vyges/sg13cmos5l_vyges_ip__ldo_capless/gds/README.md

# Layout

| File | Top cell | Size (µm) | What it is |
| --- | --- | --- | --- |
| `sg13cmos5l_vyges_ip__ldo_capless.gds` | `sg13cmos5l_vyges_ip__ldo_capless` | 527.15 × 269.00 | The LDO as a reusable block: its own prBoundary, pins named by its ports (`vin`, `vout`, `vddd`, `vss`, `vref_bg`, `ibias`, `en`, `ilim_en`, `vtrim0`–`vtrim4`, `pgood`, `oc`) |
| `slot_11.gds` | `slot_11` | 537.15 × 273.00 | The Chipalooza slot 11 hand-off: one instance of the block at (4, 2), the wrapper pins it uses, and a straight stub from each to the block pin facing it |

This is the `layout-refine` layout (2026-10-26): TopMetal1 supply grid, guard rings on every region, one digital row,
`vdd_1v2` routed 1 µm wide, `vfb` under a spacing rule, pgood above the feedback ladder. The taped-out layout
(2026-10-19) is the one on `main`.

Rebuilt 2026-11-09 for the PDK's FULL KLayout rule set: the main tables and the maximal deck, as IHP's
`run_drc.py` runs them. The earlier build passed the main tables but had 141 maximal-deck errors (LU.a 58,
NW.e1 9, M2.d 73, M3.d 1). The fixes are full-height n-ties in the pass array, the HV tap enclosure and a
min-area step.

Checks on both files (2026-11-09; IHP-Open-PDK KLayout decks, block alone and in the slot):

- DRC 0 on the full rule set (`run_drc.py`, main + maximal, no density), antenna 0, and every unused
  wrapper pin clear of our metal.
- LVS: every device and net matches except the 11 folded `rhigh` resistors. The deck extracts a serpentine
  as segment length plus bends, so it can never equal a straight schematic `l` (IHP-Open-PDK#746). Each
  is signed off by VALUE instead: its segment is drawn so that the PDK's own resistance for the folded
  device (the PyCell's `rhigh r=` value) equals the straight schematic resistor's within 0.007 %. LVS
  confirms the layout's bends and widths are the ones recorded, and LVS with the folded parameters
  substituted matches.

Generated by chipalooza `tools/slot_route_run.sh 11` from the xschem schematic in `xschem/`.
