vyges/sg13cmos5l_vyges_ip__ldo_capless/doc/figures/README.md

# LDO presentation figures

Last updated: 2026-10-18

Slide figures for `ldo_capless`, drawn with cirfig_gen (one SVG per figure, sized in pt; insert at
100 % and never resize). Each figure has its SVG, the editable JSON layout, and a PNG preview.

**These figures are drawn from descriptions. The xschem schematics in `xschem/` (generated,
ERC/LVS-checked) are the source of truth.** The xschem exports in `doc/schematics/` are unchanged.

| Figure | Size (pt) | What it shows |
|---|---|---|
| `ldo_top.svg` | 824.00 x 367.64 | Regulation loop: error amplifier `x_amp`, pass device `Mpass`, `Cc` (eout to vout), `Cout`, preload `Mpre`, feedback divider `Rtop` + `R_trim`, and the current-limit path (`Msense`, `Mcas`, `Mref`, `Mocp/Mocn`, `Mlim`). |
| `ldo_erramp.svg` | 801.43 x 322.88 | `ldo_erramp` transistor level: PMOS-input pair `M1`/`M2`, mirror load `M3`/`M4`, second stage `M5`/`M6`, Miller `Rz`-`Cm`, bias `Mr`/`Mn1`/`Mp0`/`Mtail`, enable pull-down `Men1`. |
| `ldo_ilim.svg` | 788.32 x 352.65 | `ldo_ilim`: sense `Msense` + cascode `Mcas` against `Mref` (node oc_n is the comparison), throttle `Mocp/Mocn` -> `Mlim`, OC flag `Moc`/`Roc`/`Xinv_oc`, enable `Xinv_ie`/`Mdis_oc`, sense-node sink `Msd`. |
| `ldo_trim.svg` | 829.33 x 223.19 | `ldo_fbtrim`: `Rtop`, `Rbase`, and the five binary-weighted segments `Rt0`-`Rt4` (drawn lengths 6.8/13.6/27.3/54.6/109.1 um, 1:2:4:8:16), each shorted by `Msw0`-`Msw4` on `vtrim0`-`vtrim4`. |

## Drawing conventions

- The VDD symbol is `vin` (3.3 V); the GND symbol is `vss`. `vddd` (1.2 V) appears as the terminal `VDDD` in `ldo_ilim.svg`.
- Bulk terminals are not drawn. In the schematics every PMOS bulk is `vin` and every NMOS bulk is `vss`
  (this includes `Mcas`, whose source is `sense_d` but whose bulk is `vin`).
- Terminal labels name schematic nets: VREF=vref, VFB=vfb, VEOUT=eout, VOUT=vout, IBIAS=ibias (the gate
  line of the harness bias mirror), ENn=en_n, ILIMEN=ilim_en, VDDD=vddd, OC=oc, VTRIMk=vtrimk.
  A terminal label used twice in one figure is the same net.
- Amplifier polarity in `ldo_top.svg`, derived from `ldo_erramp.sch`: `vfb` is the non-inverting input
  (vfb up -> eout1 down -> eout up) and `vref` the inverting one; the pass PMOS inverts again, so the loop is negative.
- Device multipliers are written out where they matter: `Mpass` is one device with m=64.

## Simplifications (top level only)

- `x_amp` is drawn as an amplifier symbol (its transistors are in `ldo_erramp.svg`).
- The trim ladder below `vfb` (`Rbase`, `Rt0`-`Rt4`, `Msw0`-`Msw4`) is drawn as one resistor `R_trim`; `vtrim[4:0]` is not drawn. See `ldo_trim.svg`.
- In the current limiter, `Mocp`+`Mocn` are drawn as one inverter (they are a CMOS inverter between vin and vss);
  `Msd`, `Mdis_oc`, `Xinv_ie` and the OC flag path (`Roc`, `Moc`, `Xinv_oc`) are left out. All are in `ldo_ilim.svg`.
- Not drawn: `x_vref` (shown as the VREF terminal), `x_boost`, `x_en`, `x_pg`; and the `ibias`/`en_n` pins of `x_amp`.

## Verification

Each table below was generated by extracting connectivity from the `.sch` geometry (instance pin
positions from the PDK/local symbols, nets from the xschem wire labels) and comparing it, pin by pin,
with the connectivity of the figure's own wires (union of wires, junctions and pins). The extractor
reproduces `sim/netlist/*.spice` exactly for every LDO cell. A figure passes only when every drawn
pin lands on the schematic net, no figure net joins two schematic nets, no schematic net is split
(except supplies, which have one symbol per pin by rule), and every schematic device is either drawn or
listed as not drawn. The checker was confirmed to fail on a swapped mapping before use.

Render check (`tools/render.py`): every figure reports "all wire ends on pins or wires". No wire
crossings in any LDO figure.

#### Check: ldo_top.svg vs xschem/ldo_capless.sch (flattened one level)

Devices: schematic 82 instances (flattened one level, including the hierarchy wrappers), drawn 12 symbols, two of which stand for device groups (R_trim = x_fb ladder; the inverter = Mocp+Mocn); not drawn: x_amp/ (transistors drawn in ldo_erramp.svg; shown as the amplifier symbol); x_pass (hierarchy wrapper of Mpass); x_fb (hierarchy wrapper); x_fb/Rbase (with Rt0-Rt4, Msw0-Msw4 drawn as one resistor R_trim; see ldo_trim.svg); x_il (hierarchy wrapper); x_il/Mocp (with Mocn drawn as one inverter); x_il/Mocn (drawn as the inverter); x_il/Msd (weak sense-node sink); x_il/Mdis_oc (ILIM_EN disable); x_il/Xinv_ie (ILIM_EN inverter); x_il/Roc (OC flag level shift); x_il/Moc (OC flag level shift); x_il/Xinv_oc (OC flag output; all in ldo_ilim.svg); x_vref (reference divider, shown as the V_REF terminal); x_vref/ (reference divider); x_boost (load-release slew boost); x_boost/ (slew boost); x_en (enable); x_en/ (enable); x_pg (power-good comparator); x_pg/ (power-good); x_fb/Rt0 (in R_trim); x_fb/Msw0 (in R_trim); x_fb/Rt1 (in R_trim); x_fb/Msw1 (in R_trim); x_fb/Rt2 (in R_trim); x_fb/Msw2 (in R_trim); x_fb/Rt3 (in R_trim); x_fb/Msw3 (in R_trim); x_fb/Rt4 (in R_trim); x_fb/Msw4 (in R_trim).

| Figure symbol | Schematic device | Pin | Schematic net | Figure net | Match |
|---|---|---|---|---|---|
| x_amp | x_amp | vfb | vfb | internal node | yes |
| x_amp | x_amp | vref | vref | VREF (terminal) | yes |
| x_amp | x_amp | eout | eout | internal node | yes |
| Mpass | x_pass/Mpass | G | eout | internal node | yes |
| Mpass | x_pass/Mpass | D | vout | VOUT (terminal) | yes |
| Mpass | x_pass/Mpass | S | vin | VDD symbol | yes |
| Mpre | Mpre | G | ibias | IBIAS (terminal) | yes |
| Mpre | Mpre | D | vout | VOUT (terminal) | yes |
| Mpre | Mpre | S | vss | GND symbol | yes |
| Cc | Cc | c0 | eout | internal node | yes |
| Cc | Cc | c1 | vout | VOUT (terminal) | yes |
| Cout | Cout | c0 | vout | VOUT (terminal) | yes |
| Cout | Cout | c1 | vss | GND symbol | yes |
| Rtop | x_fb/Rtop | P | vout | VOUT (terminal) | yes |
| Rtop | x_fb/Rtop | M | vfb | internal node | yes |
| Rtrim | x_fb ladder | top | vfb | internal node | yes |
| Rtrim | x_fb ladder | bot | vss | GND symbol | yes |
| Msense | x_il/Msense | G | eout | internal node | yes |
| Msense | x_il/Msense | D | x_il/sense_d | internal node | yes |
| Msense | x_il/Msense | S | vin | VDD symbol | yes |
| Mcas | x_il/Mcas | G | vout | VOUT (terminal) | yes |
| Mcas | x_il/Mcas | D | x_il/oc_n | internal node | yes |
| Mcas | x_il/Mcas | S | x_il/sense_d | internal node | yes |
| Mref | x_il/Mref | G | ibias | IBIAS (terminal) | yes |
| Mref | x_il/Mref | D | x_il/oc_n | internal node | yes |
| Mref | x_il/Mref | S | vss | GND symbol | yes |
| Xocinv | x_il/Mocp+Mocn | A | x_il/oc_n | internal node | yes |
| Xocinv | x_il/Mocp+Mocn | Y | x_il/oc_nb | internal node | yes |
| Mlim | x_il/Mlim | G | x_il/oc_nb | internal node | yes |
| Mlim | x_il/Mlim | D | eout | internal node | yes |
| Mlim | x_il/Mlim | S | vin | VDD symbol | yes |

Net check: PASS

#### Check: ldo_erramp.svg vs xschem/ldo_erramp.sch

Devices: schematic 13, drawn 13.

| Figure symbol | Schematic device | Pin | Schematic net | Figure net | Match |
|---|---|---|---|---|---|
| Mp0 | Mp0 | G | pbias | internal node | yes |
| Mp0 | Mp0 | D | pbias | internal node | yes |
| Mp0 | Mp0 | S | vin | VDD symbol | yes |
| Mtail | Mtail | G | pbias | internal node | yes |
| Mtail | Mtail | D | ptail | internal node | yes |
| Mtail | Mtail | S | vin | VDD symbol | yes |
| M1 | M1 | G | vref | VREF (terminal) | yes |
| M1 | M1 | D | n3 | internal node | yes |
| M1 | M1 | S | ptail | internal node | yes |
| M2 | M2 | G | vfb | VFB (terminal) | yes |
| M2 | M2 | D | eout1 | internal node | yes |
| M2 | M2 | S | ptail | internal node | yes |
| M3 | M3 | G | n3 | internal node | yes |
| M3 | M3 | D | n3 | internal node | yes |
| M3 | M3 | S | vss | GND symbol | yes |
| M4 | M4 | G | n3 | internal node | yes |
| M4 | M4 | D | eout1 | internal node | yes |
| M4 | M4 | S | vss | GND symbol | yes |
| M5 | M5 | G | eout1 | internal node | yes |
| M5 | M5 | D | eout | VEOUT (terminal) | yes |
| M5 | M5 | S | vss | GND symbol | yes |
| M6 | M6 | G | pbias | internal node | yes |
| M6 | M6 | D | eout | VEOUT (terminal) | yes |
| M6 | M6 | S | vin | VDD symbol | yes |
| Men1 | Men1 | G | en_n | ENn (terminal) | yes |
| Men1 | Men1 | D | eout1 | internal node | yes |
| Men1 | Men1 | S | vss | GND symbol | yes |
| Mn1 | Mn1 | G | ibias | IBIAS (terminal) | yes |
| Mn1 | Mn1 | D | pbias | internal node | yes |
| Mn1 | Mn1 | S | vss | GND symbol | yes |
| Mr | Mr | G | ibias | IBIAS (terminal) | yes |
| Mr | Mr | D | ibias | IBIAS (terminal) | yes |
| Mr | Mr | S | vss | GND symbol | yes |
| Rz | Rz | M | eout1 | internal node | yes |
| Rz | Rz | P | nzc | internal node | yes |
| Cm | Cm | c1 | nzc | internal node | yes |
| Cm | Cm | c0 | eout | VEOUT (terminal) | yes |

Net check: PASS

#### Check: ldo_ilim.svg vs xschem/ldo_ilim.sch

Devices: schematic 12, drawn 12.

| Figure symbol | Schematic device | Pin | Schematic net | Figure net | Match |
|---|---|---|---|---|---|
| Msense | Msense | G | eout | VEOUT (terminal) | yes |
| Msense | Msense | D | sense_d | internal node | yes |
| Msense | Msense | S | vin | VDD symbol | yes |
| Msd | Msd | G | ibias | IBIAS (terminal) | yes |
| Msd | Msd | D | sense_d | internal node | yes |
| Msd | Msd | S | vss | GND symbol | yes |
| Mcas | Mcas | G | vout | VOUT (terminal) | yes |
| Mcas | Mcas | D | oc_n | internal node | yes |
| Mcas | Mcas | S | sense_d | internal node | yes |
| Mref | Mref | G | ibias | IBIAS (terminal) | yes |
| Mref | Mref | D | oc_n | internal node | yes |
| Mref | Mref | S | vss | GND symbol | yes |
| Mdis_oc | Mdis_oc | G | ilim_en_n | internal node | yes |
| Mdis_oc | Mdis_oc | D | oc_n | internal node | yes |
| Mdis_oc | Mdis_oc | S | vss | GND symbol | yes |
| Mocp | Mocp | G | oc_n | internal node | yes |
| Mocp | Mocp | D | oc_nb | internal node | yes |
| Mocp | Mocp | S | vin | VDD symbol | yes |
| Mocn | Mocn | G | oc_n | internal node | yes |
| Mocn | Mocn | D | oc_nb | internal node | yes |
| Mocn | Mocn | S | vss | GND symbol | yes |
| Mlim | Mlim | G | oc_nb | internal node | yes |
| Mlim | Mlim | D | eout | VEOUT (terminal) | yes |
| Mlim | Mlim | S | vin | VDD symbol | yes |
| Moc | Moc | G | oc_n | internal node | yes |
| Moc | Moc | D | oc_lv | internal node | yes |
| Moc | Moc | S | vss | GND symbol | yes |
| Roc | Roc | M | oc_lv | internal node | yes |
| Roc | Roc | P | vddd | VDDD (terminal) | yes |
| Xinv_ie | Xinv_ie | A | ilim_en | ILIMEN (terminal) | yes |
| Xinv_ie | Xinv_ie | Y | ilim_en_n | internal node | yes |
| Xinv_oc | Xinv_oc | A | oc_lv | internal node | yes |
| Xinv_oc | Xinv_oc | Y | oc | OC (terminal) | yes |

Net check: PASS

#### Check: ldo_trim.svg vs xschem/ldo_fbtrim.sch

Devices: schematic 12, drawn 12.

| Figure symbol | Schematic device | Pin | Schematic net | Figure net | Match |
|---|---|---|---|---|---|
| Msw0 | Msw0 | G | vtrim0 | VTRIM0 (terminal) | yes |
| Msw0 | Msw0 | D | t0 | internal node | yes |
| Msw0 | Msw0 | S | t1 | internal node | yes |
| Msw1 | Msw1 | G | vtrim1 | VTRIM1 (terminal) | yes |
| Msw1 | Msw1 | D | t1 | internal node | yes |
| Msw1 | Msw1 | S | t2 | internal node | yes |
| Msw2 | Msw2 | G | vtrim2 | VTRIM2 (terminal) | yes |
| Msw2 | Msw2 | D | t2 | internal node | yes |
| Msw2 | Msw2 | S | t3 | internal node | yes |
| Msw3 | Msw3 | G | vtrim3 | VTRIM3 (terminal) | yes |
| Msw3 | Msw3 | D | t3 | internal node | yes |
| Msw3 | Msw3 | S | t4 | internal node | yes |
| Msw4 | Msw4 | G | vtrim4 | VTRIM4 (terminal) | yes |
| Msw4 | Msw4 | D | t4 | internal node | yes |
| Msw4 | Msw4 | S | vss | GND symbol | yes |
| Rtop | Rtop | P | vout | VOUT (terminal) | yes |
| Rtop | Rtop | M | vfb | VFB (terminal) | yes |
| Rbase | Rbase | P | vfb | VFB (terminal) | yes |
| Rbase | Rbase | M | t0 | internal node | yes |
| Rt0 | Rt0 | P | t0 | internal node | yes |
| Rt0 | Rt0 | M | t1 | internal node | yes |
| Rt1 | Rt1 | P | t1 | internal node | yes |
| Rt1 | Rt1 | M | t2 | internal node | yes |
| Rt2 | Rt2 | P | t2 | internal node | yes |
| Rt2 | Rt2 | M | t3 | internal node | yes |
| Rt3 | Rt3 | P | t3 | internal node | yes |
| Rt3 | Rt3 | M | t4 | internal node | yes |
| Rt4 | Rt4 | P | t4 | internal node | yes |
| Rt4 | Rt4 | M | vss | GND symbol | yes |

Net check: PASS
