vyges/sg13cmos5l_vyges_ip__ldo_capless/doc/datasheet/ldo_capless_schematic.md

# Datasheet for ldo_capless

**netlist source**: schematic

| Parameter | Unit | Min Limit | Min Value | Typ Value | Max Limit | Max Value | Status |
| :--- | :--- | ---: | ---: | ---: | ---: | ---: | :----: |
| Output voltage, mid code | V | 1.100 V | 1.208 V | 1.209 V | 1.300 V | 1.214 V | Pass ✅ |
| Output trim range, low code | V | any | 1.000 V | 1.000 V | 1.050 V | 1.000 V | Pass ✅ |
| Output trim range, high code | V | 1.750 V | 1.798 V | 1.798 V | any | 1.798 V | Pass ✅ |
| Line regulation | mV/V | any | 0.515 mV/V | 0.515 mV/V | 5.000 mV/V | 0.515 mV/V | Pass ✅ |
| Load regulation, 0-48 mA | mV | any | 0.350 mV | 0.350 mV | 20.000 mV | 0.350 mV | Pass ✅ |
| Dropout at 50 mA | mV | any | 149.987 mV | 149.987 mV | 250.000 mV | 149.987 mV | Pass ✅ |
| Quiescent current, enabled | uA | any | 37.073 uA | 41.527 uA | 60.000 uA | 44.829 uA | Pass ✅ |
| Current limit trip | mA | any | 58.499 mA | 58.499 mA | 60.000 mA | 58.499 mA | Pass ✅ |
| Phase margin over PVT | deg | 45.000 deg | 49.440 deg | 71.431 deg | any | 77.961 deg | Pass ✅ |
| PSRR at 100 Hz | dB | 50.000 dB | 52.226 dB | 52.226 dB | any | 52.226 dB | Pass ✅ |
| PSRR at 1 kHz | dB | 30.000 dB | 32.424 dB | 32.424 dB | any | 32.424 dB | Pass ✅ |
| PSRR at 10 kHz | dB | 10.000 dB | 12.495 dB | 12.495 dB | any | 12.495 dB | Pass ✅ |
| Supply rejection holds below | kHz | any | 49.407 kHz | 49.407 kHz | any | 49.407 kHz | Pass ✅ |
| Load-step droop at 19 mA/us | mV | any | 404.680 mV | 404.680 mV | any | 404.680 mV | Pass ✅ |
| Load slew rate for 120 mV droop | mA/us | 1.000 mA/us | 1.771 mA/us | 1.771 mA/us | any | 1.771 mA/us | Pass ✅ |
| Load-release overshoot | mV | any | 228.250 mV | 228.250 mV | 120.000 mV | 228.250 mV | Fail ❌ |
| Load step meeting ±120 mV | mA | 1.000 mA | 2.000 mA | 2.000 mA | any | 2.000 mA | Pass ✅ |
| Area | um2 | any |  |  | 146641.950 um2 |  | Skip 🟧 |
| Magic DRC | - | any |  |  | 0.000 |  | Skip 🟧 |
| Netgen LVS | - | any |  |  | 0.000 |  | Skip 🟧 |
| KLayout DRC | - | any |  |  | 0.000 |  | Skip 🟧 |
| Antenna violations | - | any |  |  | 0.000 |  | Skip 🟧 |

## Plots

### Loop gain and phase at the binding load

Loop gain and phase at the binding load

### Phase margin across the load range

Phase margin across the load range

### Phase margin over 243 PVT corners

Phase margin over 243 PVT corners

### Load-step response — where both failures live

Load-step response — where both failures live

### Power-supply rejection against frequency

Power-supply rejection against frequency

### Droop and overshoot against load-step size — where the promise can be set

Droop and overshoot against load-step size — where the promise can be set

---

© 2026 Vyges (https://vyges.com) · generated by `tools/datasheet.py`, do not edit by hand
