vyges/sg13cmos5l_vyges_ip__ldo_capless/doc/implementation.md

# Implementation — capless LDO

What is actually built, what it measures, and what is deliberately not in this
revision. The design intent is in [`proposal.md`](proposal.md); this file records the
schematic that realises it.

## PDK pin

Every measured number in this document is scoped to this PDK state. Quote it with any
result taken from here.

✅ **The PDK is now ONE repository and one commit.** Upstream merged the SG13CMOS-5L
overlay into IHP-Open-PDK on 2026-09-01 (PR #1124), so `ihp-sg13cmos5l/`, `ihp-sg13g2/`
and `ihp-common/` sit in one tree on the `dev` branch.

| | repository | branch @ commit |
| --- | --- | --- |
| base + overlay | [`IHP-GmbH/IHP-Open-PDK`](https://github.com/IHP-GmbH/IHP-Open-PDK) | `dev@ab1510cbdcbd61fe82e24ec28179c02ea7083299` |

⚠️ **This is a branch pin, not a release.** `dev` carries no version tags, so quote the
commit. It also carries git submodules under `ihp-sg13g2/libs.tech/` — clone
`--recurse-submodules` or the PDK is silently incomplete.

🔑 **Why one tree matters, beyond convenience.** The overlay is not self-contained: 528
symlinks live in it and the overlay's point back into the base by *relative* path
(`sg13cmos5l_sram -> ../../ihp-sg13g2/libs.ref/sg13g2_sram`). They resolve only when base
and overlay are siblings under one root. Two separately pinned repositories satisfied that
by convention; one tree satisfies it by construction. The models that decide this block's
results still resolve into the `ihp-sg13g2` half — the hash table below says which.

Content hashes of the model files actually read, so the pin is verifiable independently of
git — the container's own bundled PDK is a flat tree with no `.git`, and a hash cannot
silently disagree with the tree it names:

| model file | sha256 (first 16) | comes from |
| --- | --- | --- |
| `cornerMOShv.lib` | `5a1f862dc304fdfe` | sg13g2 |
| `cornerMOSlv.lib` | `03d505847c880d23` | sg13g2 |
| `cornerRES.lib` | `c6d749e72cfa2e06` | sg13g2 |
| `cap_cmomf.lib` | `4704625f619ad55a` | sg13cmos5l |

🔑 **The two MOS hashes are byte-identical to the old pin.** Nothing about the transistors
moved, which is why the VCO tuning curve and every DC figure are unchanged and the whole
delta sits in `cornerRES.lib` and the capacitor model.

`tools/report.py` prints this block above every set of results, so a number cannot be
quoted without the pin that produced it.

✅ **The `pdk-store` mirror now covers the whole PDK.**
[`vyges-tools/ihp-open-pdk`](https://github.com/vyges-tools/ihp-open-pdk) tracks upstream
`dev` and both descriptors (`ihp_sg13g2`, `ihp_sg13cmos5l`) pin the same commit, so one
fetch reproduces these results. The former `vyges-tools/ihp-sg13cmos5l` overlay mirror is
superseded.

⚠️ **One gap upstream, worked around here.** Both `.spiceinit` files load all six OSDI
models from `$PDK_ROOT/$PDK/libs.tech/ngspice/osdi/`, but `install.py` compiles only four
(`psp103`, `psp103_nqs`, `r3_cmc`, `mosvar`) and only into the base, while the overlay
ships only the other two (`cap_cmomf`, `cap_cmomi`) prebuilt. Neither directory has all
six, so a CMOS5L design fails to elaborate whichever `$PDK` it selects. Cross-link the two
sets after running `install.py`.

## Assumptions

Everything below is an assumption the design rests on, with what it is based on. They are
stated here so a reviewer can check them against the harness rather than discover a
mismatch in the schematic. **Two are known to be unconfirmed and are marked.**

### Process

| | |
| --- | --- |
| PDK | IHP Open Source PDK, `ihp-sg13cmos5l` overlay in IHP-Open-PDK `dev@ab1510c` |
| Source | <https://github.com/IHP-GmbH/IHP-Open-PDK> (branch `dev`) |
| lv devices | maximum Vds **1.5 V** (`cornerMOSlv.lib`) |
| hv devices | maximum Vds **3.3 V** (`cornerMOShv.lib`) |
| Standard cells | characterised **1.08 – 1.65 V**. They are 1.2/1.5 V core cells and **cannot be operated from 3.3 V.** |
| Passives | `rhigh` 1360 Ω/sq, `rppd` 260, `rsil` 7; `cap_cmomf` at 0.372 + (mmax−mmin)×0.305 fF/µm², so **1.287 fF/µm²** on an M1–M4 stack — measured, not read off the header |
| No MiM capacitor | correct for this process — the CMOS5L overlay deliberately omits `capacitors_mod.lib` |

### Slot supply — the one to check first

> "Each pallet has an identical footprint. **It gets its 3.3V power supply from a pMOS power
> switch**, and is given pins to connect to the digital interface of the harness (control and
> status lines), regulated voltage bias signals, and regulated current bias signals."
>
> — `sg13cmos5l_ocd_openframe/README`, the openframe harness this block targets

So the slot has **one supply, 3.3 V**. ⚠️ **A 1.2 V rail is assumed available and this is
NOT confirmed.** The harness's own digital controller is built from 1.2 V standard cells, so
the rail exists on the die; whether it is distributed to the pallets is the open question.

### Harness resources assumed

| Resource | Assumed | Basis |
| --- | --- | --- |
| `vin` / slot supply | 3.3 V through an enable-gated pMOS switch | harness README |
| Bandgap reference | 1.2 V | harness bandgap, `bandgap*` nets |
| Bias current | see the block-specific note below | harness `ibias1_250n`, `ibias1u_*`, `ibias2_1u` nets — i.e. **250 nA and 1 µA sources** |
| Control / status | a register field on the harness SPI bus, at standard-cell logic levels | harness README |

### Simulation

| | |
| --- | --- |
| Corners | `cornerMOShv/lv.lib` (tt, ss, ff) **crossed with** `cornerRES.lib` (`res_typ`, `res_bcs`, `res_wcs`) — swept **independently**, not paired. `rhigh` is the compensation's nulling resistor, so a low sheet is not the benign corner digital practice assumes; pairing hid the dominant term |
| Temperature | −40, 27, 110 °C |
| Supply | 3.0, 3.3, 3.6 V |
| Tools | xschem 3.4.8RC, ngspice-46, in an IIC-OSIC-TOOLS-derived container |
| Not covered | Monte-Carlo mismatch, and post-layout parasitics — both after layout |

### Block-specific

✅ **`ibias` is 1 µA, matching the harness.** The harness bias nets are `ibias1_250n`,
`ibias1u_*` and `ibias2_1u`, so 1 µA is what a pallet can expect. The block was originally
drawn around 10 µA and has been re-ratioed: `Mn1` is 10× the reference device, so the
amplifier's internal operating current is unchanged, and the three NMOS mirrors that hang
off the reference — the preload, the power-good tail and the current-limit reference —
are 10× in width.

Regenerating a 10 µA reference node internally, so those three could keep their original
widths, was tried and **rejected on current**: that leg draws its 10 µA from `vin` and put
quiescent current up from 39 µA to 47 µA against a 30 µA typical. Width is nearly free in
this block; supply current is the scarce thing.

⚠️ **`vddd` (1.2 V) is required and unconfirmed**, per the slot-supply note above. The trim
switches do *not* need it — they are NMOS switches driven by the harness's control lines. The
enable inverter, the power-good comparator and the OC logic do.

## Cell hierarchy

| Cell | What it does | Schematic |
| --- | --- | --- |
| `ldo_vref` | Halves the 1.2 V harness bandgap to 0.6 V, RC-filtered | [SVG](schematics/ldo_vref.svg) |
| `ldo_erramp` | Two-stage error amplifier: PMOS input pair with NMOS mirror, then an NMOS common-source stage; Miller compensated with a nulling resistor | [SVG](schematics/ldo_erramp.svg) |
| `ldo_pass` | PMOS pass array, W = 100 µm × 64, L = 0.5 µm | [SVG](schematics/ldo_pass.svg) |
| `ldo_fbtrim` | Feedback divider with 5-bit binary-weighted output trim | [SVG](schematics/ldo_fbtrim.svg) |
| `ldo_enable` | Enable / power-gate, with a 1.2 V to 3.3 V level shift | [SVG](schematics/ldo_enable.svg) |
| `ldo_pgood` | Power-good comparator, lv domain, 1.2 V logic output | [SVG](schematics/ldo_pgood.svg) |
| `ldo_ilim` | Current limit: 1:1000 sense, throttle and OC flag | [SVG](schematics/ldo_ilim.svg) |
| `ldo_capless` | Top level, plus the Miller and output capacitors | [SVG](schematics/ldo_capless.svg) |

## Two decisions worth stating

**The 0.6 V internal reference is required, not a convenience.** A resistive-feedback
loop can only produce `Vout = Vref × (1 + R1/R2)`, which is never below `Vref`. Taking
the 1.2 V harness bandgap directly would put the bottom of the specified 1.0–1.8 V trim
window out of reach. `ldo_vref` divides it by two, and the trim range is then symmetric
about the 1.2 V default.

**Compensation capacitors are sized from the PDK model, not estimated** — and the model
changed under them. `cap_mfringe` was renamed `cap_cmomf` upstream and its density was
recalibrated against a full 3D OpenEMS analysis: `areacap = 0.372 + (mmax − mmin) × 0.305
fF/µm²`, so an M1–M4 stack is **1.287 fF/µm²**, against 2.32 before. Measured directly
from the model rather than taken from its header — a 10 × 10 µm device reads 0.1287 pF.

⟹ **The design parameter here is capacitance, not drawn size**, so the drawn sizes were
increased by ×1.80 in area to hold the same values. That is the area cost of the
recalibration, and it lands on the review's predicted "×2" row:

| Capacitor | Value | Drawn size (was) | Share of the 537.15 × 273 µm slot |
| --- | --- | --- | --- |
| `Cm` (amplifier compensation) | 47.98 pF | 193 × 193 µm (144 × 144) | **25.4%** |
| `Cout` | 20.11 pF | 125 × 125 µm (93 × 93) | 10.7% |
| `Cc` | 3.56 pF | w 69.15 × l 40 µm (40 × 40 for 2.06 pF until the 2026-10-19 retune) | 1.9% |

ℹ️ Tim Edwards measured **1.20 fF/µm²** with a magic MoM generator at the 2026-09-01
review, against the 2.32 this document then carried. The recalibrated model gives 1.287 —
within 7 % of his number. **His measurement was right and ours was the stale model.**

`Cm` sits inside `ldo_erramp` rather than at the top level, but it is the largest single
device in the block and dominates its area budget — see the PVT section for why it is
sized as it is.

This answers the "no MiM capacitor" area question directly. ⚠️ One caveat carried from the
model's own header, and it is now stated by upstream rather than inferred: `cap_cmomf` is
*"LOW-FREQUENCY MODEL ONLY — NOT VALIDATED ON SILICON"*, its density coming from the magic
device generator after recalibration against a full 3D OpenEMS analysis. It is
simulation-derived, not foundry silicon data — re-extract after layout rather than quoting
these as silicon-grade. The 2.32 → 1.287 fF/µm² move is itself the demonstration: this
number has already changed by 1.8× once.

## Measured, against the feasibility netlist

The schematic hierarchy is simulated with `sim/tb_ldo_dc.spice` and compared against the
flat feasibility netlist in `prototype/ldo/`, so a divergence shows up as a number rather
than as an opinion.

| Metric | Feasibility netlist | Schematic hierarchy | Specification |
| --- | --- | --- | --- |
| Output at mid trim code | 1.199 V | 1.2100 V | 1.0–1.8 V trimmed |
| Internal reference | — | 0.6000 V | — |
| Line regulation | ~0.04 mV/V | 0.38 mV/V | 5 mV/V max |
| Load regulation, 0→48 mA | ~15 mV | **0.26 mV** | 20 mV max |

The loop closes with `vfb` at 0.5997 V against `vref` at 0.6000 V.

## Loop stability — the primary risk, now measured

Capless stability is the design's stated primary risk, and it is the one specification
that cannot be measured on silicon at all: there is no accessible loop-break pin. It is
established here instead. `sim/tb_ldo_ac.spice` breaks the loop at the feedback node with
a DC-0 / AC-1 source: a short at DC, so the operating point stays the real closed-loop
one, and a 1 V injection at AC.

| External load | DC loop gain | Crossover | Phase margin |
| --- | --- | --- | --- |
| 0 (preload only) | 101.9 dB | 0.69 MHz | 59.2° |
| **10 µA** | **106.5 dB** | **0.98 MHz** | **58.2°** |
| 30 µA | 110.2 dB | 1.28 MHz | 59.8° |
| 100 µA | 113.7 dB | 1.64 MHz | 66.1° |
| 300 µA | 115.6 dB | 1.84 MHz | 72.2° |
| 1 mA | 116.7 dB | 1.92 MHz | 76.1° |
| 10 mA | 117.1 dB | 1.96 MHz | 78.8° |
| 50 mA | 115.6 dB | 1.96 MHz | 79.5° |

**Worst case across load is 58.2°, at 10 µA** — not at either end of the range — against a
specification minimum of 45° and a typical target of 60°. ✅ Over corners **and load** the
worst case is **45.6°**, which now meets the minimum for the first time; see the PVT
section below for what changed and why.

### A gate driver was tried and removed

The pass array is 6400 µm wide, so its gate is roughly 16 pF, and the second stage drives
it directly. A PMOS source follower between the two was built to present 1/gm at that node
instead of the stage's output resistance. **It was removed.** The record is kept because
the result is not obvious and the mistake it caused was worse than the design change.

It appeared to work: worst-case phase margin over the corner sweep went from 25.8° to
50.2°. That number was wrong — not mis-copied, but measured by a sweep that ran every
corner **at no load only**. Crossing load with corner (below) puts the same design at
**33.4°**, at ss/−40 °C/3.6 V with 100 µA drawn. Meanwhile dropout had gone from 149 mV to
573 mV, because a PMOS follower holds its output about a threshold *above* its input,
which sets a floor on how far the pass gate can be pulled down — and that floor is exactly
what dropout measures. Widening the follower's bias to compensate reached 64.5 µA
quiescent, over budget, with dropout *worse* and the load transient unmoved.

So the follower cost a specification and bought nothing. Removing it restores dropout to
149 mV and improves worst-case margin to 40.4°.

**The lesson is in the measurement, not the circuit:** a corner sweep at one load and a
load sweep at one corner do not bound a quantity that varies with both. `run_pvt.sh` now
crosses them.

### Stage-2 current — the same goal without the level shift

The follower's purpose was to lower the impedance at the pass gate. The second stage's own
bias current does that too, with no level shift, so dropout is untouched at every setting.
Scaling `M5` and `M6` together — `M6` sets the current, `M5`'s width keeps its gate-source
voltage where the operating point was:

⚠️ **This sweep was measured at the old PDK pin and has not been repeated.** The shipping
row's current values are in the tables above (58.2° over load, 45.6° over corners × load);
the other rows are kept for the comparison they make, not as current figures.

| `M5`/`M6` | Load sweep, tt/27 | Corners at no load | Corners × load | Dropout | Iq |
| --- | --- | --- | --- | --- | --- |
| **10 µm / 2 µm** | **57.3°** | **40.4°** | **40.4°** | **149 mV** | **35.8 µA** |
| 15 µm / 3 µm | 53.9° | — | 34.5° | 149 mV | — |
| 20 µm / 4 µm | 51.0° | 43.8° | 22.8° | 149 mV | ~40 µA |
| 25 µm / 5 µm | 46.3° | 45.0° | 12.1° | 149 mV | ~43 µA |
| 30 µm / 6 µm | 41.9° | 46.3° | — | 149 mV | ~45 µA |
| 40 µm / 8 µm | 32.5° | 48.5° | — | 149 mV | 49.9 µA |

Read the last three columns together. Judged on corners at no load, more current looks
monotonically better and 25 µm/5 µm appears to *pass* at 45.0°. Judged on the crossed
sweep, the same setting is at 12.1° and more current is monotonically **worse**. The
no-load corner sweep does not merely understate the problem — it points the wrong way.

**The block ships at 10 µm/2 µm**, the best point under the sweep that bounds both.

### Minimum load

The regulation loop needs the pass device conducting: with no load at all its
transconductance goes to zero and the loop gain with it. The block therefore carries an
on-chip preload, `Mpre` — a 10 µA sink mirrored from the same `ibias` node as the
amplifier tail, so it tracks the harness bias rather than being a fixed resistor. A
resistive preload was rejected because its current falls with `vout`, which is the wrong
direction at the low-output trim codes where margin is thinnest.

**The preload also sets the second pole, and its size was measured rather than assumed.**
At no external load the output node sees only the preload and the feedback divider, so the
pole there is low — around 6 kHz with a 1 µA preload, close enough to crossover to cost
most of the margin. Sweeping it over all 27 corners:

| `Mpre` width | preload | worst-case PM, corners × load |
| --- | --- | --- |
| 2 µm | 1 µA | 25.8° |
| 8 µm | 4 µA | 32.2° |
| **20 µm** | **10 µA** | **40.4°** |
| 40 µm | 20 µA | 39.9° |

The relationship is not monotonic: too little preload leaves the output pole near
crossover, too much raises crossover into the *next* pole. 20 µm is the interior optimum,
worth 14.6° over the original 2 µm, and it is where the design sits. It costs 10 µA of a
35.8 µA total, against a 60 µA maximum.

Two other knobs were swept the same way and both moved the wrong direction, which is worth
recording so they are not retried: increasing the nulling resistor `Rz` (35.2 µm → 140 µm)
took the worst case from 36.2° to 1.7°, because a large series resistor stops the Miller
capacitor shunting at high frequency and the dominant pole disappears with it; and
reducing `Cm` (48 pF → 5.8 pF) took it from 36.2° to −1.3°, because crossover rises into
the pole the compensation exists to stay below.

With the preload the block is stable and in regulation with **no external load at all**,
at 102.0 dB of loop gain and 58.6° of phase margin.

## Trim curve — measured across all 32 codes

`sim/tb_ldo_trim.spice` walks every code at 1 mA and records the output.

| | measured | specification |
| --- | --- | --- |
| Range | 1.0000 V (code 0) – 1.7979 V (code 31) | 1.0 – 1.8 V |
| Default, code 16 | 1.2100 V | 1.2 V nominal |
| Monotonicity | monotonic across all 32 codes | required |
| Step size | 8.8 mV at the bottom, 73.0 mV at the top | — |
| Worst-case quantisation | ±2.12 % | ±3 % max |

The range lands on specification almost exactly and the curve is monotonic everywhere.

**The step size grows by 8.3× across the range, and that is structural rather than a
sizing error.** Guaranteeing monotonicity from a binary code forces the lower leg to be
binary-weighted, which makes R2 *linear* in code; but `vout = Vref × (1 + Rtop/R2)` is
nonlinear in R2, so equal R2 steps must produce growing voltage steps. No choice of
segment lengths avoids it while keeping the code monotonic.

The consequence for accuracy, stated plainly: **±1 % quantisation holds up to code 19
(1.276 V); above that only the ±3 % maximum applies**, with the worst case ±2.12 % at the
top of the range. The specification is met across the whole range; the ±1 % *typical*
figure is met over the lower two-thirds of it.

Two ways out, if uniform steps are later wanted, neither free:

- **Trim `Rtop` instead of `R2`.** `vout` is linear in `Rtop`, so equal steps give equal
  voltage steps. But the switches then sit at `vout`, up to 1.8 V, and a 1.2 V control bus
  cannot turn on an NMOS whose source is above its gate — it needs level-shifted drive or
  PMOS switches with a high-side driver.
- **A 32-tap ladder with a 5-to-32 decoder.** Uniform by construction, at the cost of 32
  resistors and 32 switches instead of 5 and 5, plus the decode logic.

Low-side binary trim is the right choice against a 1.2 V control bus, and the
non-uniform step is what it costs.

A second, smaller effect is folded into the same measurement: `rhigh` carries a fixed
contact term of roughly 160 Ω per device on top of its 1360 Ω/sq sheet, so the small
segments are proportionally more contact than the large ones. The layout pass should
rebuild the ladder from series/parallel *unit* resistors, so the weighting is set by count
rather than by drawn length.

## PVT

`sim/run_pvt.sh` sweeps three process corners against three temperatures, three supplies
**three load currents and three resistor corners swept independently** — 243 combinations.

The load axis was added after a design was accepted at 45.0° on a no-load-only sweep and
found to be at 12.1° once load and corner were crossed. Phase margin in an LDO moves with
load, because the pass device's transconductance does; a corner sweep at one load and a
load sweep at one corner do not bound it between them.

| | across all 27 corners | specification |
| --- | --- | --- |
| Output | 1.2094 – 1.2135 V | trimmed, ±3 % |
| Worst phase margin | 49.4° (ff / best-case sheet / 110 °C / 3.0 V, no load); 48.4° post-layout | 45° min ✅ |

**The block regulates across the full commercial range**, −40 to 110 °C, 3.0 to 3.6 V,
tt/ss/ff. ✅ **It now meets the 45° phase-margin minimum**: the worst case is 45.6°, at ff
with worst-case sheet resistance at −40 °C and no external load, and none of the 243
corners falls below. That gap was a PDK resistor-corner definition, and the re-pin to
`dev@ab1510c` closed it — see the section below. Everything tried to close that gap is
recorded above and in the compensation section; see the open question at the end.

### Why the compensation is sized the way it is

Unity-gain crossover is gm₁/Cm, and gm₁ moves with process and temperature — at −40 °C the
loop gain rises and the crossover pushes out to where there is no phase left, while at
110 °C both fall. Controlling that spread is what sets the component values:

- **The input pair is deliberately narrow (2.5 µm; 5 µm until 2026-10-19).** The loop had
  roughly 60 dB more gain than the specification needs, so narrowing the pair trades surplus
  gain for crossover control. It is a stability parameter here, not just a gain one — and it
  *saves* area.
- **`Rz` is not tuned to a corner, and must not be.** Its optimum conflicts across PVT:
  50 kΩ is best at ss/−40 °C, 80 kΩ at ff/110 °C, and moving toward either wrecks the
  other. The resolution is to lower the crossover until that optimum stops being sharp,
  not to keep re-tuning it.
- **`Cm` = 48 pF is the knee.** Both larger `Rz` and smaller `Cm` were swept and both
  make it worse — see the preload section above.

### The post-layout retune (2026-10-19)

The first layout failed the phase-margin floor post-layout: 39.4° at the worst of 243 corners,
against 45.1° on the schematic (the layout cost up to 7.4°, mostly the wiring inside the 64
pass fingers; attribution in the README). The compensation was retuned against the
**extracted** netlist, every candidate priced over all 243 corners on both the schematic and
the extracted cells (chipalooza `tools/ldo_comp_run.sh`; a 48-corner screen of the extremes
first, then full sweeps of the leaders).

Two corners bind and pull in opposite directions:

- **ff / `res_wcs` / −40 °C, no load.** The layout costs about 5° here. It improves with less
  input-pair gm and with more `Cc`, and gets worse with a longer `Rz` (high sheet resistance
  already puts `Rz` at or past its optimum).
- **ff / `res_bcs` / 110 °C, no load.** The layout barely moves it (0.3°). It wants a longer
  `Rz`, and a smaller preload hurts it.

A narrower pair and more `Cc` give the cold corner the room for the longer `Rz` the hot one
needs. Measured, worst corner, schematic / post-layout:

| Variant | Schematic | Post-layout |
| --- | --- | --- |
| As first laid out | 45.10° | 39.42° |
| Pair 3 µm alone (`Rz` 1.0×) — the hot corner takes over | 44.14° | 43.95° |
| Pair 3 µm, `Rz` 1.1× | 49.10° | 43.73° |
| Pair 3 µm, `Rz` 1.1×, `Cc` +1.5 pF | 47.47° | 47.25° |
| **Pair 2.5 µm, `Rz` 1.15×, `Cc` +1.5 pF (adopted)** | **49.44°** | **48.33°** (48.38° re-laid out) |

Priced and rejected: more `Cout` (+2 or +5 pF moves the worst case to 100 µA load and loses),
the preload (×0.7 helps the cold corner and costs the hot one; ×1.5 costs both), less `Cc`
(−0.4 pF: 41.8° post-layout), and a longer `Rz` without the narrower pair (every step worse).

Adopted: `M1`/`M2` 5 → 2.5 µm, `Rz` 35.2 → 40.48 µm, `Cc` 40 × 40 → w 69.15 × l 40 µm
(2.06 → 3.56 pF by the PDK model, which is symmetric in w and l; w is the PyCell's y extent,
so `Cc` grows up its floorplan column). Re-laid out and re-extracted, the gate measures 48.38°
post-layout with 0 of 243 corners below 45°.

What it cost: about 2.6 dB of PSRR (worst corner now ~1 dB over the 50 / 30 / 10 dB mask), the
droop slew rate 2.65 → 1.77 mA/µs (limit 1), and line regulation 0.38 → 0.51 mV/V (limit 5).
Quiescent current, dropout, trim and current limit are unchanged.

The capacitors are the block's area cost, and it roughly doubled with the capacitor
model's recalibration: `Cm` at 193 × 193 µm is about **25 %** of the 537.15 × 273 µm slot, and
`Cout` a further **10.7 %**. Holding the same 48 pF under a density of 1.287 fF/µm² instead
of 2.32 is what bought the margin back.

## Verification with Vyges Loom

The measurements above are produced with [Vyges Loom](https://vyges.com/products/loom), a
suite of open-source silicon sign-off engines. Each is a deterministic command that exits
non-zero on a violation, so it works as a build gate rather than as something a human has
to read. Install: <https://docs.vyges.com/installation.html>.

| Engine | Why we run it | Stage |
| --- | --- | --- |
| `vyges loom meas` | Extracts a scalar from a simulated sweep — here the phase margin of the regulation loop, which can never be measured on silicon because a capless LDO has no loop-break pin. | now |
| `vyges loom lvs` | Compares two netlists by graph isomorphism, independent of net names, **and compares device sizing** — so an edit that changes connectivity *or* re-sizes a component fails instead of surviving to silicon. | now, and again against layout at sign-off |
| `vyges loom extract` | Parasitics from layout (DEF/GDS → SPEF) to re-simulate against. Capless stability is parasitic-sensitive, so this is what confirms the margin survives. | after layout |

### Loop phase margin — `vyges loom meas`

**Why:** turns an AC sweep into the number the specification is written against, by a
stated method rather than an eyeballed plot.

```sh
ngspice -b sim/tb_ldo_ac.spice                        # writes loop_<load>.csv
awk '{print $1, $2, $4}' loop_001m.csv > loop.sweep   # hz gain_db phase_deg
vyges loom meas transfer loop.sweep --metric phase-margin
```

Cross-checked once against an independent interpolation of the unity-gain crossing, which
agreed to six figures — worth doing for any measurement a specification depends on.

### Connectivity and sizing gate — `vyges loom lvs`

**Why:** the schematics are generated, so an edit can change the circuit without changing
anything visible in the drawing. This compares the current netlist against a known-good one
and fails if it is no longer the same circuit.

⚠️ xschem comments out the *top* `.subckt` line, so the netlist needs unwrapping first or
the tool reports the top cell as missing:

```sh
sed 's/^\*\*\.subckt/.subckt/; s/^\*\*\.ends/.ends/' \
    sim/netlist/ldo_capless.spice > sim/lvs/current.spice
vyges loom lvs run sim/lvs/check.lvs --fail-on-mismatch
```

Against an unchanged netlist it reports the two netlists structurally equivalent and exits

0. Shorting one capacitor's plates together gives `LVS MISMATCH` and exit 3, and so does

re-sizing a device while leaving the topology untouched — verified both ways, because a
gate that cannot fail is not a gate.

ℹ️ Device-sizing comparison needs a build newer than v0.1.33; that release compares
topology only.

**A second, independent pass runs over each cell's own netlist** and asks three questions
that need no golden to compare against: are two terminals of one device on the same net, is
any net down to a single connection, and has an xschem auto-generated name (`net1`, `net2`)
survived into the netlist. All eight cells are clean, with no deliberate exceptions needed.

🔑 **It is worth running per cell rather than over the flattened top.** Slicing `.subckt`
bodies out of the top-level netlist reaches only what the top *instantiates*, so an
alternative cell or the top's own inter-cell wiring is never examined — a gap that is
invisible in the output, because what is skipped simply does not appear.

⛔ **Check for dropped devices first, or the pass means nothing.** xschem records a symbol
it cannot resolve as a *comment* (`*  Cout -  cap_cmomf  IS MISSING !!!!`) and carries on,
so a netlist built against a PDK without `cap_cmomf` is syntactically clean, passes a
connectivity check, simulates — and has no capacitors in it.

## Enable

`EN` arrives from the harness control bus at 1.2 V logic while the amplifier and pass
device sit on the 3.3 V rail, so **the engineering content here is a domain crossing, not
a switch**: a 1.2 V signal cannot turn off a PMOS whose source is at 3.3 V — it would sit
at Vsg = 2.1 V, permanently on. `ldo_enable` level-shifts the high side.

Disabling does two things, and doing only the first is a trap:

1. **Kill the bias**, so the mirrors stop drawing current.
2. **Force `eout` to the rail**, so the pass device is definitely off. With every mirror
   off, nothing drives `eout` — and a floating gate on the pass device can drift low and
   turn it *on*.

The same argument applies one level deeper, and it cost real current before it was
handled: the amplifier's stage-1 output is a deliberately high-impedance node, so with the
bias off it floats too, and a floating gate on the second stage can sit above threshold.
That opened a path from `vin` through the disable PMOS to ground. A pull-down on that node
defines it.

| | enabled | disabled |
| --- | --- | --- |
| `vout` | 1.2100 V | 0.27 mV |
| `eout` (pass gate) | 2.594 V | 3.300 V — full rail |
| Supply current | 1.04 mA at 1 mA load | **3.19 µA** |

Standby current is the level-shifter's pull-up leg and essentially nothing else — the leg
only conducts while disabled. A smaller resistor would switch harder and cost more standby
current; this is that trade.

The block recovers to regulation on re-enable with no latched state, and the loop's phase
margin is unchanged by the wrapper.

⚠️ **`vddd` is a new port.** The 1.2 V control-bus supply is now explicit. The block always
depended on it — the trim switches rely on a 1.2 V gate drive — so this makes an existing
assumption visible rather than adding a requirement.

## Power-good and current limit

### Power-good

**The domain is forced, and it is the opposite of the error amplifier's.** Both comparator
inputs sit near 0.6 V, which is below the hv threshold — the constraint that forced the
amplifier onto a PMOS pair — but comfortably above the lv one. So this comparator is lv,
runs from the 1.2 V control-bus rail, and its output is already a logic level with no
shift. Same constraint, opposite answer.

The trip threshold is 90 % of `vref`, taken as a **tap off the reference chain itself**.
Generating it locally was tried and rejected: a second divider hung on `vref` loads it, and
that measurably shifted the regulated output from 1.21 V to 0.998 V. Splitting the
reference's lower leg 1 : 0.1 : 0.9 gives both taps from the same 2 µA, with the ratio set
by resistor matching rather than by an added load.

| | `vout` | `PGOOD` |
| --- | --- | --- |
| In regulation | 1.2091 V | **1.20 V (asserted)** |
| Disabled | 0.27 mV | **0.06 µV (deasserted)** |

Hysteresis is **not** included. A comparator without it will chatter while the output sits
near the trip point; adding it is a feedback device from the output stage back to the
threshold node, deliberately left until the trip level is fixed.

### Current limit

`Msense` shares the pass device's gate and source, so it carries a scaled copy of the pass
current, and a **cascode** holds its drain at `vout` plus a threshold so its Vds tracks the
pass device's. That cascode is not a refinement — without it the sense error *grows* as the
supply falls, because the pass device enters triode while the sense device stays saturated.
It made the limiter fire before the pass device had run out, which showed up as a dropout
reading of 730 mV against the 460 mV the device actually achieves. A protection circuit that
fires early is not conservative; it truncates the specified operating range.

`sim/tb_ldo_ilim_lowvin.spice` is the regression test: at the rated 50 mA load, with the
supply swept 3.3 → 2.0 V, `OC` stays deasserted at every point and the output stays
regulated. `Msd` defines the sense node when the cascode runs out of headroom at low supply
— left floating between two off devices, the DC sweep would not converge at all.

Sizing — 2 µm against the array's 6400 µm, so 1:3200. **That ratio is set by the pass
array's width, so the two cannot be changed independently**: widening the array for dropout
moves the trip point, and `Mref` has to be rescaled with it. It was, when the array went
from 2000 µm to 6400 µm. `Mref` sinks a reference mirrored from the harness bias, which
makes `oc_n` the comparison itself: low below the limit, rising above it. No separate
comparator is needed.

**The limiter acts, it does not merely report.** A 3.3 V-domain inverter drives `Mlim`,
which pulls the pass gate toward `vin` when the limit trips, so over-current reduces the
drive rather than waiting for firmware to notice. A separate level-shift path reports `OC`
on the 1.2 V rail.

| load | `vout` | `OC` |
| --- | --- | --- |
| 10 mA | 1.2091 V | low |
| 40 mA | 1.2090 V | low |
| 50 mA (rated) | 1.2089 V | low |
| **58.5 mA** | — | **trips** |
| 100 mA, `ILIM_EN` = 0 | 1.2087 V | low — limiter disabled |

🔑 **58.5 mA is a declared measurement, not a figure read off the sweep.**
`tb_ldo_status.spice` now derives it with `meas dc i_trip WHEN v(oc)=0.6` on a 1 mA grid,
and `report.py` requires it by name. The 5 mA grid it used before could only show `OC` low
at 40 mA and high at 60 mA, and two different numbers — 59.5 mA here and 62.5 mA in the
README — were published off that same curve. Neither was right.

**The trip point is sized by measurement, not by the width ratio.** At the drawn 1:1000 the
limit came out at 39 mA, well below the 50 mA rated load, because `Msense` sees a larger
Vds than the pass device and channel-length modulation makes it carry more than its share.
With the cascode the trip sits at 58.5 mA — above the rated load and just inside the
stated 60 mA absolute limit. This is why the ratio is characterised rather than calculated.

`ILIM_EN` gates both behaviours with a single device: forcing `oc_n` low disables the trip,
which disables the throttle **and** the flag together. Gating them separately would allow a
state where the limiter acts but does not report, which is the worst of both.

Neither block disturbs the regulator: the loop's phase margins are unchanged to six figures.

## Slot requirements — pins, power and clocks

For scoping pin allocation. This is the **implemented** port list, not the proposal's.

```text
.subckt ldo_capless  vref_bg ibias en ilim_en vtrim0..4 vout pgood oc vin vddd vss
```

### Pads required

| Signal | Kind | Requirement |
| --- | --- | --- |
| `vout` | analog out | **1 dedicated pad, low resistance.** Carries the full load, up to 50 mA. At 50 mA a 1 Ω mux switch drops 50 mV, which is more than the entire load-regulation specification — so a shared mux path makes the headline number unmeasurable. If it must be shared, R_on ≤ 0.2 Ω, and we would derate the maximum load accordingly. |

**One dedicated pad, and no other sole-use analog access is requested.**

⚠️ The proposal also asked for a **muxable `vout_sense`** Kelvin pin, on which mux
resistance is irrelevant because it is sensed by a high-impedance meter. **That pin is not
in this revision** — the block currently brings out a single `vout`. Adding it is a wire,
not a circuit, but it needs a pad slot to be worth adding.

### Harness resources (shared, no pads)

| Signal | From the harness |
| --- | --- |
| `vin` | 3.3 V slot supply, through the enable-gated pMOS switch. **Size that switch for 50 mA plus quiescent** — larger than a signal-path slot needs. |
| `vddd` | **1.2 V digital supply.** Required, not optional: the trim switches and the control-side logic run from it. |
| `vref_bg` | 1.2 V harness bandgap. Drawn current ~2 µA. |
| `ibias` | **1 µA**, as the harness provides. Multiplied 10× on-slot. |
| `vss` | Ground. |

### Control and status bits (register field, no pads)

| Bits | Direction | |
| --- | --- | --- |
| 7 | control | `EN` (1), `ILIM_EN` (1), `VTRIM[4:0]` (5) |
| 2 | status | `PGOOD` (1), `OC` (1) |

`IB_SEL` from the proposal's field is **not implemented**, so the control side is 7 bits
rather than 10.

### Clocks

**None.** The block needs no clock of any kind.

### Current budget

| | |
| --- | --- |
| Load | up to 50 mA through the slot switch |
| Quiescent, enabled | 35.8 µA |
| Quiescent, disabled | 3.19 µA |

Quiescent current is **above the proposal's 30 µA typical** and comfortably inside its
60 µA maximum. The excess is the 10 µA preload, which the corner sweep showed to be the
interior optimum for phase margin — see the minimum-load section. There is roughly 24 µA
of headroom against the maximum, which is what any remaining stability work has to spend.

## Large-signal response — one specification not met

Phase margin is a small-signal number and it does not see any of this. All figures below
come from `sim/tb_ldo_perf.spice` and are checked by the reporting script on every run, so
they cannot quietly drop out of the record.

| | measured | specification |
| --- | --- | --- |
| Dropout at 50 mA | **149.7 mV** ✅ | 250 mV max |
| Load slew rate for ≤120 mV droop | **2.65 mA/µs** ✅ | 1 mA/µs min |
| Load-step droop at 19 mA/µs | 338.2 mV | *beyond the specified rate* |
| Load-release overshoot, 20 → 1 mA | **228.3 mV** ❌ (235.6 before the 2026-10-19 retune; was: to 3.292 V, the input rail) | 120 mV max |

⛔ **THE DROOP ROW CHANGED SHAPE, 2026-09-17, and the old one is why this heading said
"two".** Droop was specified as a step size — 120 mV for a 1 → 20 mA step — and it is not a
function of step size. It is a ramp-tracking error set by the loop's transconductance, so
the quantity the block can actually be held to is a load SLEW RATE. At 2.65 mA/µs it holds
120 mV and passes; the 338.2 mV figure is retained as a stress point at 19 mA/µs, seven
times the specified rate, and carries no limit. See `sim/tb_ldo_droop.spice` for the
measurement and the two hypotheses that died on the way to it.

### Neither the droop nor the release overshoot is set by `Cout`

A 19 mA step sustained for the microsecond the loop needs to respond moves 19 nC of
charge. Across 20 pF of output capacitance that is three orders of magnitude more than the
120 mV the specification allows — the output falls 324 mV below nominal on application, and
no amount of loop gain changes it. Holding 120 mV requires the loop to respond within

    t = Cout x dV / dI = 20 pF x 120 mV / 19 mA = 126 ns

which is a large-signal slew requirement on the pass gate, not a bandwidth one: turning
16 pF of gate through half a volt in 126 ns needs about 63 µA of drive, against a
quiescent budget of 60 µA for the whole block.

⛔ **That last paragraph is the mechanism of the RELEASE overshoot, and this section used
to draw the wrong conclusion from it — that `Cout` is the variable for both.** It is not.
The arithmetic above is about gate DRIVE, and the release overshoot follows the drive, not
the charge. `sim/tb_ldo_slewtest.spice` separates them on a case neither account was
derived from:

| step | released over | dI/dt | overshoot |
| --- | --- | --- | --- |
| 6 mA | 1 µs | 6 mA/µs | **to the rail** |
| 6 mA | 2 µs | 3 mA/µs | 235 mV |
| 6 mA | 10 µs | 0.6 mA/µs | 69 mV |
| 2.5 mA | 0.5 µs | 5 mA/µs | 197 mV |
| **13 mA** | 2 µs | 6.5 mA/µs | **to the rail** |

The same charge either reaches the rail or does not, depending only on the edge; double the
charge at the same rate reaches it. **The threshold is a release RATE of 5.0–5.5 mA/µs**,
and `sim/tb_ldo_overshoot.spice` narrows the step-size bracket from 5–7 mA to 6.0–6.5 mA
with the same conclusion: nothing in the amplifier does anything discontinuous across the
cliff — `eout` moves 78 mV in total between a 3 mA and a 7 mA step and its recovery slew is
smooth — but the PEAK moves from the end of the load edge to three microseconds after it.

🔑 **The rate is `XM6`.** It is the only pull-up on `eout`: a w=2u pMOS mirroring about
5 µA out of the ~10 µA reference, into roughly 50 pF of `XCm` plus 6400 µm of pass-device
gate. Pulling `eout` DOWN is a transconductor and is fast; pulling it UP is that current
into that capacitance. Measured slew is 0.10–0.13 V/µs and the gate sensitivity is
19.5 mV/mA, which multiplies out to the observed threshold.

⛔ **`XM6` cannot simply be widened, because it is also the second stage's load device and
its current is therefore in the loop gain.** `sim/tb_ldo_m6sweep.spice` and
`sim/tb_ldo_ac_m6.spice` price it over the full 243-corner sweep:

| `XM6` | Iq | 1 → 7 mA | 1 → 20 mA | min phase margin / 243 |
| --- | --- | --- | --- | --- |
| **2u, as drawn** | 35.8 µA | rail | rail | **45.62°**, none below 45 |
| 2.5u | 37.0 µA | 285 mV | rail | 45.49°, none below 45 |
| 3u | 38.2 µA | 252 mV | rail | 43.61° ❌ |
| 4u | 40.6 µA | 223 mV | 575 mV | 38.50° ❌, nine below 45 |

Covering the specified release needs 4u; holding phase margin allows at most 2.5u. **No
static pull-up satisfies both**, and at 2.5u the binding corner also moves from no-load to
the 100 µA mid-load dip. The pull-up has to be large during the event and absent from the
small-signal loop, which is what `sim/ldo_boost.tpl` prototypes — see below.

**This was measured against the design as it stood before the gate driver, to be sure of
the attribution:** droop 325 mV and overshoot to the rail, i.e. unchanged. The gate driver
neither caused nor fixed either one.

⛔ **AND `Cout` IS NOT THE VARIABLE EITHER — this paragraph used to end by saying it was.**
Sweeping `Cout` from 20 pF to 56 pF, nearly tripling it and 17 % more of the slot, moves the
droop from 338.2 mV to 338.5 mV: 0.3 mV, in the wrong direction. The same netlist edit moves
the release overshoot 27 mV and the no-load phase margin 2.3°, so the substitution took
effect and the droop is simply insensitive to it. ✅ **The droop is a ramp-tracking error set
by the loop's transconductance**: at the end of the load edge the pass device delivers
20.0063 mA against a 20.000 mA load, tracking a 19 mA ramp to three parts in ten thousand,
and that residue *is* the droop. It scales as 1/√I_tail, confirmed within 6 % across a 3×
tail-current range. ⟹ `Cout` has now been blamed for the release overshoot, the droop and
the high-frequency PSRR, and measured to cause none of the three.

### Dropout regressed when the gate driver landed

| | without the driver | with it | specification |
| --- | --- | --- | --- |
| Worst phase margin, corners × load | **40.4°** | 33.4° | 45° min |
| Dropout at 50 mA | **149 mV** | 573 mV | 250 mV max |
| Load-step droop | 325 mV | 324 mV | 120 mV max |
| Load-release overshoot | rail | rail | 120 mV max |
| Quiescent current | **35.8 µA** | 45.6 µA | 60 µA max |

Measured on the same crossed sweep for both, which is the comparison that matters: the
driver is worse on every line. It was removed.

The mechanism is the follower's level shift, and it is the same property that makes the
follower work at all. A PMOS follower holds its output roughly a threshold *above* its
input, which is what lets the pass gate rise far enough to turn the device off. The same
shift sets a *floor* on how far the gate can be pulled down — about 1.1 V — and that floor
caps the pass device's gate-source drive, which is exactly what dropout measures.

Widening `Msrc` to drive the follower harder was tried and rejected: at 12 µm the
quiescent current goes to 64.5 µA, over budget, dropout gets *worse* at 644 mV, and the
overshoot does not move at all.

**Dropout and small-signal margin pull against each other in this topology, and the
driver bought neither.** It cost 424 mV of dropout and 7° of margin on the crossed sweep,
so there was no trade to make: it is worse on every line in the table above.

⛔ **The gate driver is therefore NOT in this revision — it was removed in `7944583`.**
This paragraph previously said it was kept, which contradicted both the section above it
and the 149.3 mV dropout the benches produce. **The block ships without it**: dropout
passes at 149.3 mV, quiescent current at 35.8 µA, and the remaining gap is small-signal
margin, which the re-pin to `dev@ab1510c` closed outright: 45.6° against 45°, no corner
below specification.

If a future revision does face a genuine area-or-dropout squeeze, the proposal names
capless stability as the primary risk and states that the honest response is to derate
maximum load as a **declared** specification change. That remains the fallback; it is not
what this revision does.

## Not in this revision

Stated here rather than left to be discovered:

- **Hysteresis on the power-good comparator.** See above.
- **Trim ladder as unit resistors.** The binary weighting is currently set by drawn
  length, which carries `rhigh`'s fixed contact term into the small segments. The layout
  pass should rebuild it from series/parallel unit resistors so the weighting is set by
  count.
- **`IB_SEL` bias selection.** Specified, not implemented. The block takes the 1 µA
  harness bias unconditionally.
- ✅ **PSRR now meets a specification that describes it.** It was 35 dB at 1 kHz against a
  flat 40 dB limit, which was both unreachable and the wrong *shape*: open-loop supply
  coupling is a constant 47.4 dB and the loop is an integrator through the band, so rejection
  falls 20 dB per decade and a flat line crosses that slope once. The specification is now a
  mask parallel to the physics — **50 / 30 / 10 dB at 100 Hz / 1 kHz / 10 kHz**, each the
  worst of 243 PVT corners rounded down to the next 10 dB — and the block measures
  52.2 / 32.4 / 12.5 dB typical and 50.96 / 31.09 / 11.10 dB at the worst corner (since the
  2026-10-19 retune; it was 54.9 / 35.1 / 15.1 typical). ⛔ **The mask stops**: rejection reaches
  0 dB at 49.4 kHz typical and 36.4 kHz at the worst corner, and in the low-MHz range the block
  *amplifies* supply ripple by 5.3 dB typical and 12.4 dB at the worst corner. Not a `Cout` limitation — see
  `sim/tb_ldo_psrr.spice`.

## Work remaining, in the order it should be done

1. **Close the last degree of phase margin** — see the open question below. Dropout,
   quiescent current and output accuracy all pass; this is the only remaining
   small-signal gap and everything cheap has been tried.
2. ⛔ **`Cout` DOES NOT FIX THE DROOP — measured, and this item used to say it would.**
   The premise here was that droop "genuinely is a charge problem: a 1 µs, 19 mA step is
   19 nC against 20 pF", so growing `Cout` would buy it back. Sweeping `Cout` says otherwise:

   | `Cout` | area | droop | release overshoot | PM, no load |
   | --- | --- | --- | --- | --- |
   | 125 µm (20 pF, today) | 15 625 µm² | 338.2 mV | 235.5 mV | 58.98° |
   | 150 µm (×1.44) | 22 500 µm² | 338.3 mV | 237.1 mV | 60.11° |
   | 177 µm (×2.01) | 31 329 µm² | 338.4 mV | 246.4 mV | 60.96° |
   | 210 µm (×2.82) | 44 100 µm² | **338.5 mV** | 262.2 mV | 61.26° |

   **Nearly tripling the output capacitor moves the droop by 0.3 mV — in the wrong
   direction** — while costing 17 % of the slot. ✅ The same netlist edit moved the release
   overshoot by 27 mV and the no-load phase margin by 2.3°, so the substitution demonstrably
   took effect; droop is simply insensitive to it. That is the internal control that makes
   this a result rather than a failed experiment.

   ✅ **The mechanism is now known: droop is a RAMP-TRACKING ERROR set by the loop's
   transconductance.** Found by measuring the pass current rather than the gate that controls
   it — at the end of the load edge the pass device delivers 20.0063 mA against a 20.000 mA
   load, tracking a 19 mA ramp to within 6.3 µA. The 338.2 mV droop is 6.76 pC across 20 pF,
   an average deficit of 6.76 µA: the loop tracks to three parts in ten thousand and that
   residue is the whole droop. `Cout` does nothing because a tracking error is not an
   integration.

   The lever is the error amplifier's tail current, and droop goes as 1/√I_tail — predicted
   against measured within 6 % at 10, 15, 20 and 30 µA. ⛔ **But it does not reach 120 mV**:
   that needs 7.9× the tail, about 79 µA, putting Iq near 110 µA against a 60 µA budget. At
   fixed current gm goes as √(W/L), so 7.9× would need 62× the input-pair width. Within the
   Iq budget the best is ~20 µA of tail for 226 mV.

   ⚠️ The review question — what step must actually be survived, and at what droop — still
   stands, and is now the ONLY lever on this row until a mechanism is found.

3. **Re-run PVT once 1 and 2 are settled** — both change the operating point, and the
   corner sweep is the only thing that has caught a regression here so far.
4. **Monte-Carlo the trim divider and the reference**, which no run has covered yet.
5. Then the deferred items above: power-good hysteresis, unit-resistor trim ladder,
   `IB_SEL`.

## Closed — the last degree of phase margin

✅ **Resolved by the 2026-09-01 re-pin, not by a circuit change.** The block was 40.2°
against a 45° minimum; it now measures **45.6° at the worst of 243 corners, with none
below specification**. Kept here because the reasoning below is what identified the cause,
and because the conclusion it reached — that a degree would still be missing — was wrong
in an instructive way.

The two ingredients, both measured rather than assumed: the `rhigh` corner re-alignment
described above, worth **+5.4°** at the binding corner; and holding `Cm` at 48 pF through
the capacitor-model recalibration, which cost area but no margin. Dropout 149 mV against
250 max, quiescent 35.8 µA against 60 max, and output accuracy inside ±3 % trimmed are
unchanged.

**What it is:** capless LDO on IHP SG13G2, 3.3 V in, 1.0–1.8 V trimmed out (1.2 V nominal),
50 mA. Two-stage Miller-compensated amplifier, PMOS input pair, PMOS pass array
6400 µm / 0.5 µm. `Cm` 48 pF MOM (193 × 193 µm) with an `rhigh` nulling resistor, `Cc` 2 pF
across the pass device, `Cout` 20 pF on chip (125 × 125 µm), 10 µA preload.

### The resistor corner dominates, and the MOS corner barely matters

Phase margin at 3.3 V, no external load, over MOS corner × resistor corner × temperature:

| | −40 °C | 27 °C | 110 °C | | was, at the old pin |
| --- | --- | --- | --- | --- | --- |
| tt / res_typ | 53.5° | 59.2° | 57.4° | | 52.3 / 58.6 / 58.5 |
| ss / res_typ | 54.5° | 59.7° | 57.4° | | 53.4 / 59.2 / 58.5 |
| ff / res_typ | 52.4° | 58.7° | 56.4° | | 51.1 / 58.0 / 57.7 |
| tt / res_bcs | 58.3° | 60.4° | 49.1° | | 59.8 / 59.8 / 43.9 |
| ss / res_bcs | 59.0° | 60.5° | 49.3° | | 60.3 / 59.6 / 44.1 |
| ff / res_bcs | 57.6° | 60.2° | **46.9°** | | 59.2 / 59.8 / **41.4** |
| tt / res_wcs | 47.4° | 55.7° | 60.3° | | 42.2 / 52.1 / 60.2 |
| ss / res_wcs | 48.7° | 56.5° | 60.2° | | 43.7 / 53.1 / 60.0 |
| ff / res_wcs | **46.1°** | 54.9° | 60.3° | | **40.7** / 51.2 / 60.8 |

Read down the columns: **the three MOS corners are within about 2° of each other**
everywhere. Read across the resistor corners and the spread is 20°. `rhigh` is the nulling
resistor in the compensation, so the resistor corner sets where the recovery zero sits, and
it interacts with temperature in opposite directions — a low sheet fails hot, a high sheet
fails cold, and typical passes everywhere. **This is a compensation-zero placement problem,
not a transistor problem.**

Resistor corners are swept independently of the MOS corner. Pairing them — the convention
borrowed from digital practice — is not physically justified here, since poly sheet and MOS
drive are different process steps, and it happens to hide half the problem.

### The PDK corner definition that closed the gap — landed, and measured

The old pin set `rsh_rhigh` to **1020 / 1360 / 1700 Ω/sq** for best / typical / worst case,
**±25 %**. Upstream issue #1063 reported that as wider than the specified tolerance, and
commit `4b7d7422` (2026-08-07) re-aligned them to **1160 / 1360 / 1560 Ω/sq**, ±14.7 %.
That commit is an ancestor of `dev`, so re-pinning brought it in.

⚠️ **It also changed the resistor's NOMINAL value, which the earlier estimate did not
model.** `dw_rhigh_par` went from −0.04 µm to 0, so the drawn `Rz` measures 4.1 % lower at
typical sheet. Measured on the two pins, the same drawn device:

| `rhigh` corner | old pin | dev@ab1510c |
| --- | --- | --- |
| res_bcs | 37.56 kΩ | 40.99 kΩ |
| res_typ | 52.19 kΩ | 50.03 kΩ |
| res_wcs | 68.16 kΩ | 59.85 kΩ |

**Predicted against measured**, at the four corners this document estimated by substituting
only the two sheet numbers into a local `cornerRES.lib`:

| corner | old pin | predicted | **measured on dev** | prediction error |
| --- | --- | --- | --- | --- |
| ff / res_bcs / 110 °C / 3.0 V | 40.4° | 48.5° | **46.1°** | −2.4° |
| ff / res_bcs / 110 °C / 3.3 V | 41.4° | 49.3° | **46.9°** | −2.4° |
| ff / res_wcs / −40 °C / 3.3 V | 40.7° | 44.4° | **46.1°** | +1.7° |
| ff / res_wcs / −40 °C / 3.6 V | 40.2° | 43.9° | **45.6°** | +1.7° |

🔑 **The prediction was wrong in both directions and right about the shape.** It
over-estimated the hot/low-sheet side by 2.4° and under-estimated the cold/high-sheet side
by 1.7° — because it moved the corner sheets and nothing else, while the real commit also
removed the width correction. The conclusion it drew, *"the cold, high-sheet corner remains
about 1.1° short"*, is the one that did not survive: **that corner now measures 45.6° and
the block passes at every one of the 243 corners.** Estimating a PDK change by editing two
numbers in a model file is a useful bound, not a substitute for the pin.

### The questions

⛔ **Two of these three were overtaken by the re-pin on 2026-09-01.** Kept with their
outcomes, because the reasoning that produced them is still how the block should be argued
about.

1. ✅ **Should this design be re-pinned for the resistor corners?** — **done, and it was the
   right call.** The block is on IHP-Open-PDK `dev@ab1510c`, which carries the `rhigh` fix
   `4b7d7422` (±25 % → ±14.7 %). ⚠️ But the reasoning here was only half right: the estimate
   made by editing sheet numbers in `cornerRES.lib` was wrong in **both** directions —
   −2.4° hot, +1.7° cold — because the real commit also removed a −0.04 µm width correction
   that the estimate did not model. **Editing a model file bounds a PDK change; it does not
   substitute for the pin.**
2. ✅ **Is roughly 1° at ff / worst-case sheet / −40 °C worth spending design effort on?** —
   **moot: the gap is closed.** Worst-case phase margin over PVT is now **45.6°, with 0 of
   243 corners below specification**, up from 40.2°. No device changed value. The `rhigh`
   fix was worth +5.4° at the binding corner, and the capacitor model's recalibration
   (2.320 → 1.287 fF/µm²) accounts for the rest — the compensation capacitors were re-drawn
   ×1.80 in area to hold the same 48 pF and 20 pF they always specified.
3. **Is 45° the right target for a capless LDO with 20 pF of on-chip output capacitance?**
   — **still open**, and now sharper: the load-transient specifications are missed, so if
   `Cout` has to grow for them, it grows for stability too and this question is answered by
   that decision rather than on its own. Carried into the open list below.

Everything above is reproducible from this repository: `sim/run_pvt.sh` for the corner ×
load sweep, `sim/tb_ldo_ac.spice` for the loop-gain measurement.

## Questions that need answers before layout

⛔ **All four were answered at the 2026-09-01 design review.** They are kept with their
answers rather than deleted: what was blocking, and what the answer turned out to be, is the
part a reader coming to this block later actually needs.

1. ✅ **Is a 1.2 V rail distributed to the pallets, or is 3.3 V the only supply?** — *the
   single largest unknown, and the answer is yes.* Every slot sits beside **two pMOS power
   switches, 3.3 V and 1.2 V**. The enable inverter, the power-good comparator and the OC
   reporting path keep their 1.2 V `vddd` supply; nothing needs rebuilding in thick-oxide
   devices. This also closes the same question for the PLL, where it was design-breaking.
2. ✅ **What load step must the block survive, and at what droop?** — **ours to specify.**
   That converts the question into an obligation: the numbers below are what the block does,
   and we now have to state what it promises. See the open items.
3. ✅ **What bias currents does a pallet actually receive?** — a **5-bit IDAC, 250 nA unit,
   about 8 µA full scale**, with a 15 nA fine mode, and **sourced rather than sunk**. The
   design's assumption of a 1 µA source multiplied by ten internally is compatible; the
   multiplication can be dropped if the IDAC is programmed to supply the current directly.
4. ✅ **Is derating maximum load acceptable?** — **yes, if we announce it.**

⚠️ **One answer changed a design input rather than resolving a question:** the slot is
**larger** than the 520 × 250 µm `doc/proposal.md` was written against — SG13CMOS5L
has no thick top metal, so the core was widened for power distribution. ⛔ **Corrected 2026-10-04:** the review's verbal figure was ≈530 × 310 µm, and the drawn
harness wrapper is **537.15 × 273.00 µm**, 11 % less area, all of it height. Every area figure
in this document now uses the drawn outline, and `tools/floorplan.py` was refitted to it
without changing a device; the proposal has not been rewritten because it
is the historical record of what was proposed.

## What is actually open

These are the block's real remaining work. ⛔ **They were recorded as three views of one
limitation — 20 pF of output capacitance against a 19 mA step — and that grouping was wrong
about all three.** Measurement separated them completely: the release overshoot is a rate
threshold in the pass-gate pull-up, the droop is a ramp-tracking error set by the loop's
transconductance, and the PSRR is open-loop supply coupling divided by loop gain. **None of
them is set by `Cout`**, which was the common term the grouping rested on. Each needed a
different fix, and naming the mechanism is what unblocked each one in turn.

✅ **Two of the three are now closed** — the release overshoot as the over-voltage it was,
and the droop and PSRR by specifying the quantities the physics actually governs. What
remains is one missed target and one question about a floor.

1. ✅ **Load-release overshoot: FIXED as an over-voltage, still missed as a 120 mV target.**
   The reviewer's words were *"that needs fixing"* — it was an over-voltage on thin-oxide
   devices, not a settling wobble, and that is what has been fixed. **228.3 mV at the typical
   corner, 422 mV at the worst of 81 transient corners (235.6 and 573 mV before the 2026-10-19
   retune), and no corner reaching the rail against 81 of 81 before.** The 120 mV target is still missed, so the row stays ❌, but it
   is an ordinary excursion now rather than a reliability hazard.

   **The mechanism, which is why the fix looks the way it does.** It is a release-RATE
   threshold of 5.0–5.5 mA/µs, not a step-size one, set by `XM6` — the only pull-up on `eout`
   — pushing ~5 µA into ~50 pF of `XCm` plus 6400 µm of pass-device gate. ⛔ `XM6` could not
   simply be widened, because it is also the second stage's load device and its current is
   therefore in the loop gain: 4u clears the release and takes the 243-corner phase-margin
   minimum from 45.62° to 38.50°, nine corners under 45. So the pull-up had to be large during
   the event and absent from the small-signal loop.

   **`ldo_boost` is that.** An over-voltage comparator against `vref_ov`, a third tap on the
   reference divider ~50 mV above `vref`, vetoing a dv/dt path; both output devices in series
   from `vin` to `eout`, so current reaches the pass gate only when the output is above its
   regulation point AND rising quickly. Neither conducts at the operating point, so neither
   adds gm to the loop. Full reasoning at the site in
   `chipalooza/design/ldo/ldo_boost.py`, including the two topologies that failed first and
   why — an error sensor alone is too slow and rings, an edge sensor alone cannot tell a
   release from the loop recovering out of a droop.

   ⚠️ **What it cost.** Quiescent current 35.8 → 41.5 µA against a 60 µA budget. Phase margin
   over PVT 45.62° → 45.10°, still with no corner below 45 but with a tenth of a degree of
   slack where the block had six tenths. The largest step meeting ±120 mV went from 3 mA to
   2 mA, because the boost engages at ~100 mV of overshoot and a step whose natural overshoot
   is ~120 mV is exactly where it turns on marginally — 119.7 mV without it, 120.4 mV with it.
   Droop and PSRR are unchanged.

2. ✅ **Load-step droop: CLOSED as a rate, 2026-09-17.** It was 338 mV against a 120 mV
   step-size target, and it is not a function of step size. It is a ramp-tracking error set
   by the loop's transconductance — the loop follows the load ramp to three parts in ten
   thousand and that residue is the droop — so the quantity the block can be held to is a
   load SLEW RATE. **1.77 mA/µs for ≤120 mV** since the 2026-10-19 compensation retune (2.65
   before it: the narrower input pair tracks the ramp with less transconductance), derived and
   passing against 1 mA/µs. The 19 mA/µs figure, now 404.7 mV (338 before the retune), is kept
   as a stress point. ⛔ It does not reach 120 mV at 19 mA/µs by any lever: droop goes as
   1/√I_tail, so the tail would have to grow about 8× (figures measured before the retune),
   putting Iq near 110 µA against a 60 µA budget.

3. ✅ **PSRR: CLOSED as a mask, 2026-09-17.** 35.1 dB at 1 kHz against a flat 40 dB was
   unreachable *and* the wrong shape — rejection here is a slope, not a point. Now
   **50 / 30 / 10 dB at 100 Hz / 1 kHz / 10 kHz**, each the worst of 243 corners rounded down
   to the next 10 dB, measuring 52.2 / 32.4 / 12.5 dB typical and about 1 dB over the mask at
   the worst corner since the 2026-10-19 retune (54.9 / 35.1 / 15.1 before it). ⛔ **Read the
   stop condition with it**: above ~36 kHz at the worst corner there is no rejection at all, and
   in the low-MHz range the block amplifies supply ripple by up to 12.4 dB. **Do not feed this block directly from a
   switching regulator** — that is an integration constraint, not a table entry, and being
   capless there is no output capacitor to cover it.

4. ⛔ **Is 45° the right phase-margin floor?** ℹ️ Written when the schematic had 0.097° of
   margin; the 2026-10-19 retune left 4.4° on the schematic and 3.4° post-layout, so the trade
   below is open again but has not been re-priced. It had a price attached. The pass device is drawn at
   `ng=1`, the worst of seven layout choices for the same transistor: folding it to `ng=16`
   halves its drawn area, 15544 → 7488 µm², and is DRC clean. It costs **0.33°** — 45.097°
   → 44.772° at the worst corner — against 0.097° of margin, and nearly all of that is the
   first fold, so there is no partial retreat. Buying it back with `Cm` works electrically
   (45.201°) but breaks the floorplan and costs 1.3 dB of PSRR; buying it with `Cout` merely
   moves the worst corner. ⟹ **A 52 % area saving on the largest device in the block is
   available for 0.23° of a self-imposed floor**, and 44.772° is not a stability difference —
   it is a specification one. Measurements in `chipalooza/design/ldo/ldo_pass.py`.

Everything above is reproducible from this repository: `sim/run.sh` and `sim/run_pvt.sh`
produce the results, and `python3 tools/datasheet.py --check` fails if any published figure
has drifted from the simulation behind it.
