vyges/sg13cmos5l_vyges_ip__ldo_capless/doc/figures/ldo_erramp.png

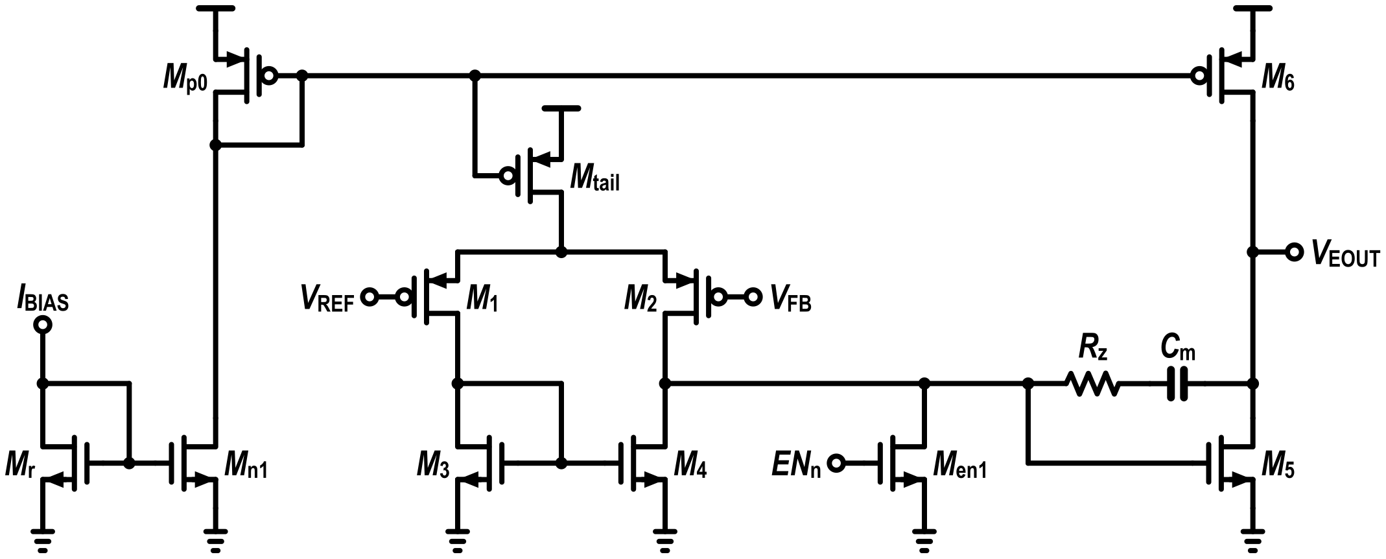
doc/figures/ldo_erramp.png
