vyges/sg13cmos5l_vyges_ip__ldo_capless/doc/figures/ldo_top.png

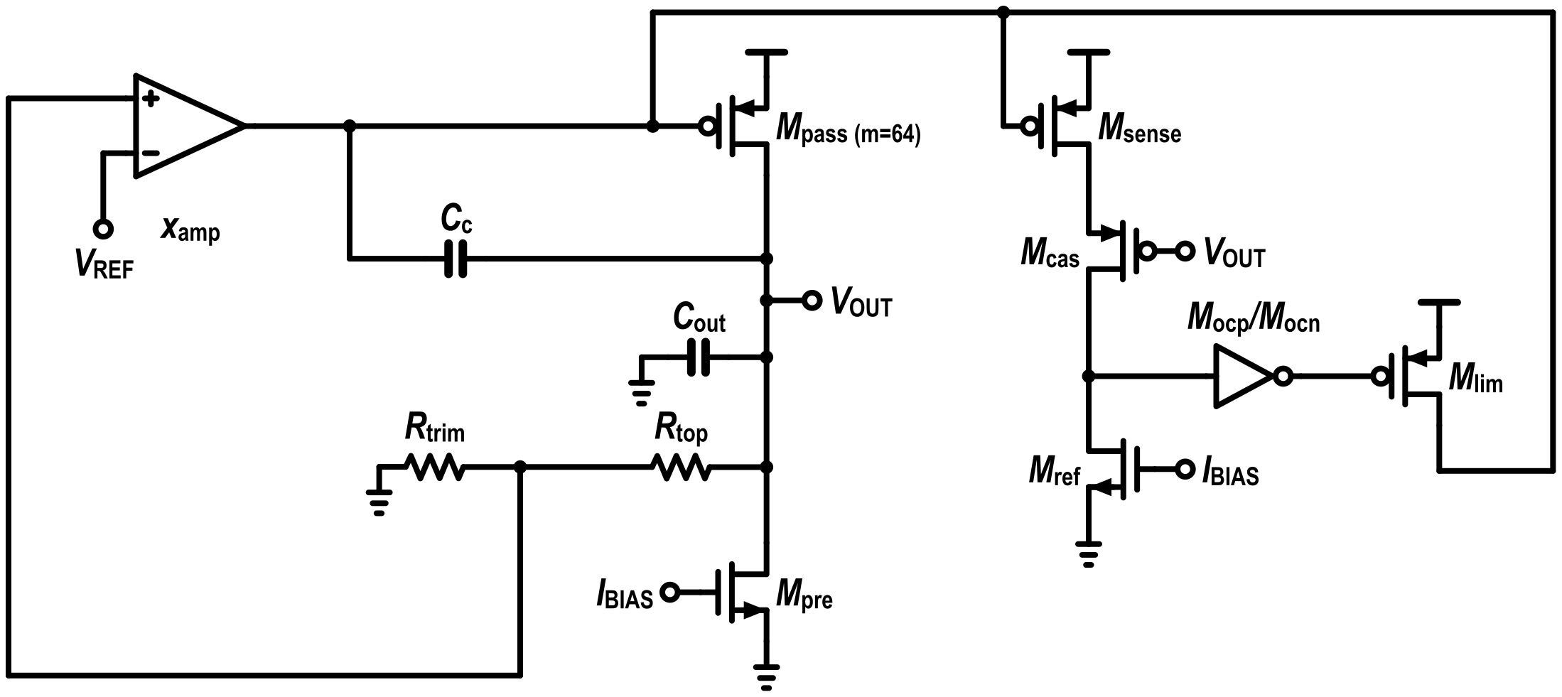
doc/figures/ldo_top.png
