vyges/sg13cmos5l_vyges_ip__ldo_capless/doc/figures/ldo_trim.png

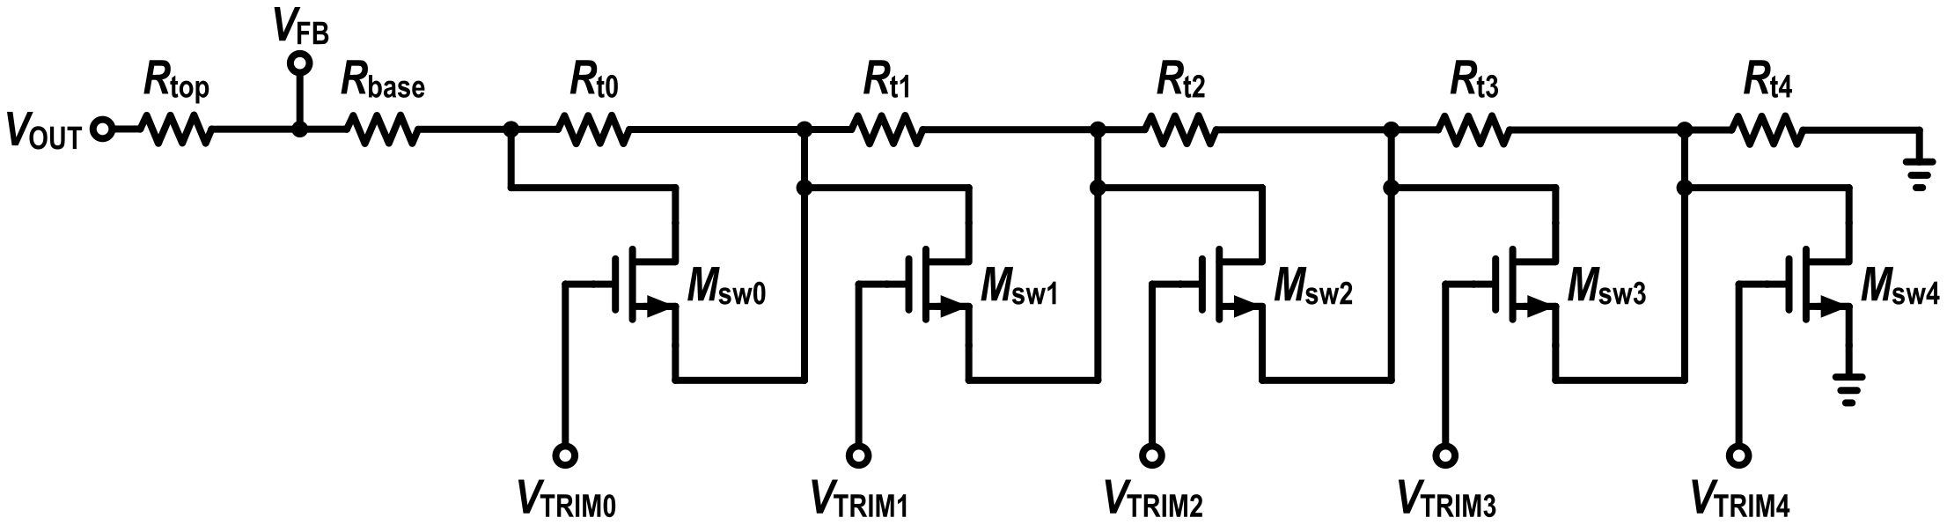
doc/figures/ldo_trim.png
