vyges/sg13cmos5l_vyges_ip__ldo_capless/xschem/ldo_boost_wired.png

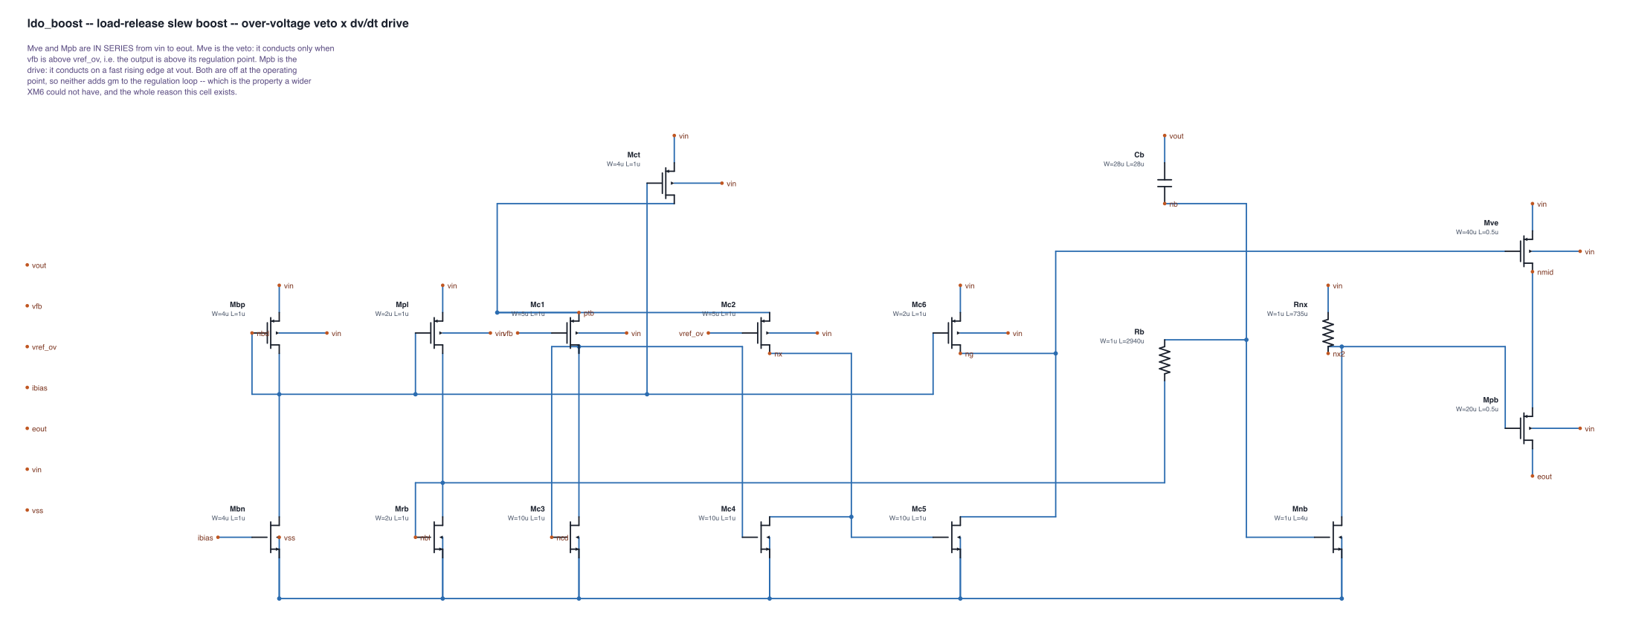
xschem/ldo_boost_wired.png
