vyges/sg13cmos5l_vyges_ip__ldo_capless/(commit log)

2026-07-23 Initial commit: capless LDO IP for Chipalooza #2 (IHP SG13CMOS5L)
    All-CMOS capless LDO -- 3.3V in, digitally-trimmable 1.0-1.8V out, internally
    compensated (no MiM, no external cap), sized to an openframe analog slot with a
    4-wire Kelvin output. Includes the submission proposal (doc/proposal.md) and the
    feasibility netlist (prototype/ldo/ldo.spice): a stable, well-damped capless loop
    demonstrated in-process on SG13CMOS5L (Vout 1.199V, line reg ~0.04 mV/V, load
    transient recovers 3.85us). Apache-2.0.
2026-08-29 schematic: xschem hierarchy for the capless LDO (Gate 1)
    Five cells: ldo_vref (1.2 V harness bandgap halved to 0.6 V), ldo_erramp
    (5T OTA, sg13_hv), ldo_pass (PMOS array W=100u x 20), ldo_fbtrim (feedback
    divider with 5-bit binary-weighted trim) and the ldo_capless top level.
    The 0.6 V internal reference is required, not incidental: a resistive-feedback
    loop can only make Vout >= Vref, so the 1.2 V harness bandgap puts the bottom of
    the 1.0-1.8 V trim window out of reach.
    Compensation capacitors are sized from the PDK cap_mfringe model rather than
    assumed: areacap = 0.67 + (mmax-mmin)*0.55 fF/um2 gives 2.32 fF/um2 on an M1..M4
    stack, so 20 pF is 93 x 93 um -- 6.6% of a 520 x 250 um slot. T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
    [ldo_capless.sch, ldo_erramp.sch, ldo_fbtrim.sch, ldo_pass.sch, ldo_vref.sch]
2026-08-29 doc: implementation record, rendered schematics, and NOTICE
    README moves from proposal status to schematic, and doc/implementation.md
    records what is built, what it measures against the feasibility netlist, and
    what is deliberately not in this revision.
    doc/schematics/ holds an SVG of every cell plus a block diagram, so the design
    can be reviewed without installing xschem. The per-cell SVGs are rendered from
    the .sch files themselves, so the picture cannot drift from the netlisted
    circuit.
    Adds NOTICE for Apache-2.0 attribution: the IHP Open Source PDK supplies the
    device models, symbols and standard cells the schematics reference, and none of
    it is redistributed here.
2026-08-29 schematic: draw real wires between components, not label-only connectivity
    Every cell is now routed: connections are declared pin-to-pin in the cell
    description and routed orthogonally, so the drawing carries actual wires. The
    previous revision connected devices by matching net labels -- which netlists
    correctly and is unreadable, because a reviewer sees isolated transistors
    instead of a circuit. The top level draws its sub-blocks as symbols with named
    pins so the signal path can be followed end to end.
    Routing introduced two shorts that the picture looked fine with and only the
    netlist exposed: a shared routing channel merged the Miller capacitor plates
    (eout onto vout), and a stub label l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
    [ldo_capless.sch, ldo_erramp.sch, ldo_fbtrim.sch, ldo_pass.sch, ldo_vref.sch]
2026-08-29 schematic: realign the reference block and regenerate
    x_vref is placed level with the amplifier vref pin rather than with the block
    centre. Sharing a height with the vfb pin put the vref wire inside vfb approach
    run, shorting the reference to the feedback and opening the loop -- the DC sweep
    went to 3.3 V unloaded and negative under load.
    Regenerated against the improved router. Every cell netlist now compares
    whole-file against the verified version and the DC testbench reproduces its
    numbers exactly: 1.2086 V out, 0.044 mV/V line, 17.3 mV load over 0-48 mA.
    [ldo_capless.sch, ldo_erramp.sch, ldo_fbtrim.sch, ldo_vref.sch]
2026-08-29 sim: open-loop gain and phase across load — the primary risk, measured
    Adds the AC loop-gain testbench. The loop is broken at the feedback node by an
    inductor that is a short at DC and an open at AC, so the operating point stays
    the real closed-loop one while the sweep sees an open loop.
    Across 1-50 mA the loop holds 87.6-88.4 degrees of phase margin against a 45
    degree specification minimum, so the capless topology is stable with wide margin
    at the typical corner. Confirmed two ways: vyges-meas transfer and an
    independent interpolation of the unity-gain crossing agree to six figures.
    At true no load the DC loop gain collapses to -16 dB and there is no crossover.
    That is not an oscillati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
2026-08-29 doc: record the Loom commands and results used to verify this block
    Documents what was actually run, why each engine is run, and what it returned:
    vyges loom meas for the loop phase margin -- the one specification that cannot
    be measured on silicon, since a capless LDO has no loop-break pin -- and
    vyges loom lvs as a name-independent connectivity gate against a known-good
    netlist.
    Both are shown with the exact command, the real output, and the confirmation
    that the gate fails when it should: shorting a capacitor gives LVS MISMATCH and
    exit 3. Records the xschem gotcha too, that the top .subckt line is commented
    out and needs unwrapping before lvs will find the top cell.
    Links to the produc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
2026-08-29 design: add a minimum-load preload, fixing regulation at no load
    The regulation loop needs the pass device conducting. With no external load its
    gm collapses, DC loop gain fell to -16.3 dB with no crossover, and the block
    stopped regulating -- 1.180 V at 0 mA against 1.2086 V at 1 mA, a rising load
    regulation, which is the wrong sign for an LDO and was the clue.
    Sweeping load from zero upward located the edge at about 10 uA, so this needs a
    defined minimum load rather than a redesign. Mpre is a 10 uA sink mirrored from
    the same ibias node as the amplifier tail, so it tracks the harness bias. A
    resistive preload was rejected: its current falls with vout, the wrong direction
    at the low-output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
    [ldo_capless.sch]
2026-08-29 sim: trim curve across all 32 codes
    Range 0.9996 to 1.7971 V against a 1.0 to 1.8 V specification, monotonic across
    every code, default code 16 at 1.2086 V.
    The step grows 8.3x across the range, from 8.8 mV to 72.9 mV, and that is
    structural rather than a sizing error: guaranteeing monotonicity from a binary
    code forces R2 linear in code, while vout = Vref(1 + Rtop/R2) is nonlinear in
    R2, so the voltage steps must grow. No segment sizing avoids it while keeping
    the code monotonic.
    Consequence recorded honestly: plus/minus 1 percent quantisation holds to code
    19 (1.275 V), above which only the plus/minus 3 percent maximum applies, worst
    case 2.11 percent. The specification is met across the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
2026-08-29 sim: PVT sweep, and the cold-temperature defect it exposed
    27 corners: three process, three temperatures, three supplies, measuring output
    accuracy and loop phase margin at no external load.
    Phase margin holds wherever the block regulates -- worst case 47.7 degrees at
    ff/110C/3.6V against a 45 degree minimum. But the block does not regulate at
    -40C at all: 1.09 V at tt and 0.51 V at ss, with loop gain below unity.
    The cause is structural and is now understood. Both amplifier inputs sit at
    0.6 V, because the trim range demands a reference below 1.0 V. The shipped
    amplifier uses an hv NMOS input pair whose threshold is about 0.7 V, so the pair
    never leaves subthreshold -- the tail node measu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
2026-08-29 doc: keep the public record to what the IP is, not how we got here
    Trims the design-process narrative out of the public implementation notes: the
    defect diagnosis, the measured before/after of the preload, and the discussion
    of the drafted replacement amplifier all belong in the internal repo, which
    already carries them in full.
    What stays public is what a user or reviewer needs: the preload as a described
    feature with its measured effect, the verified numbers, and a plain statement
    that the block is not yet validated below 0 C with a revised input stage in
    progress. That limitation is stated rather than omitted -- trimming scope is not
    the same as hiding a specification gap.
2026-08-29 sim: simplify the loop break to a single injection source
    A DC-0 / AC-1 source is the whole mechanism: a short at DC, so the operating
    point is the real closed-loop one, and a 1 V injection at AC. The parallel 1 TH
    inductor added nothing and put two zero-impedance elements across the same node
    pair, which is a degenerate loop for the DC solve and is actively hostile in
    transient.
    Re-ran every load point after the change: DC loop gain and phase margin come out
    bit-identical to the published figures (65.448397, 87.585877, 88.386999 degrees),
    so the existing results stand and need no correction.
2026-08-29 design: two-stage PMOS-input error amplifier; regulates across all PVT corners
    Replaces the single-stage NMOS-input amplifier, which could not work at this
    input common mode. Both amplifier inputs sit at 0.6 V because the trim range
    needs a sub-1.0 V reference, and an hv NMOS pair with a 0.7 V threshold never
    leaves subthreshold there. The PMOS pair sees about 1.8 V of Vsg instead.
    That forces a second stage: a single-stage PMOS amplifier leaves saturation
    above about 1.3 V output while the pass gate must reach 2.5-3.1 V. The second
    stage is an NMOS common-source device against a current-source load, Miller
    compensated with a nulling resistor. The resistor is not optional -- plain
    Miller co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
    [ldo_erramp.sch]
2026-08-29 design: phase margin now holds across all 27 PVT corners
    Worst-case phase margin 50.1 degrees at ss/-40C/3.6V against a 45 degree
    minimum, with output 1.2094 to 1.2135 V across every corner. The block now
    regulates and stays stable over the full commercial range.
    Two changes, and the reasoning matters more than the values.
    The input pair narrows from 20u to 5u. Crossover is gm1/Cm and gm1 moves with
    process and temperature -- at -40C the gain rose and crossover pushed out to
    3 MHz where no phase remains, while at 110C both fell, a 5x swing. The loop had
    about 60 dB more gain than the specification needs, so narrowing the pair trades
    surplus gain for crossover control, lifting ss/-40C from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
    [ldo_erramp.sch]
2026-08-29 doc: bring the LDO record in line with the shipped design
    The amplifier redesign and the compensation work landed ahead of the write-up,
    leaving stale figures behind. Refreshes them against the current design:
    - loop gain and phase margin vs load re-measured (worst case is now 64.3 degrees
    at 10 uA, not at either end of the load range)
    - minimum-load section quotes the current 104.4 dB / 66.5 degrees / 0.38 mV
    - trim curve re-run on the final design: 1.0007 to 1.7992 V, code 16 at 1.2100 V
    - the Loom example output shows a current measurement rather than an old one
    - the loop-break description matches the simplified single-source bench
    README moves from preliminary targets to measured va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
2026-08-30 doc: restore the Loom verification section and add Cm to the area table
    The earlier public-exposure trim removed the whole Verification with Vyges Loom
    section from the LDO, including the commands, the links and the results -- more
    than was intended. Restored, factual, with the sizing-comparison capability and
    the note that it needs a build newer than v0.1.33.
    Cm is the largest single device in the block at 16 percent of the slot and was
    missing from the capacitor table because it sits inside the amplifier rather
    than at the top level.
2026-08-30 doc: the open-items list still named three things that are done
    Temperature range, AC loop gain and the 32-code trim curve are all measured and
    documented above; listing them as pending was misleading. What remains from this
    list is the enable, power-good and current-limit wrapper, plus rebuilding the
    trim ladder from unit resistors at layout.
2026-08-30 design: enable / power-gate with a 1.2 V to 3.3 V level shift
    EN arrives from the control bus at 1.2 V while the amplifier and pass device sit
    on the 3.3 V rail, so the work here is a domain crossing rather than a switch: a
    1.2 V signal cannot turn off a PMOS whose source is at 3.3 V.
    Disabling has to do two things and doing only the first is a trap. Killing the
    bias stops the mirrors, but with every mirror off nothing drives eout, and a
    floating pass gate can drift low and turn the device ON. Mdis forces eout to the
    rail through the level shifter.
    The same argument applies one level deeper and it cost real current. The
    amplifier stage-1 output is deliberately high impedance, so it floats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
    [ldo_capless.sch, ldo_enable.sch, ldo_erramp.sch]
2026-08-30 design: power-good comparator and current limit
    Power-good is an lv-domain comparator. Both its inputs sit near 0.6 V, below the
    hv threshold but comfortably above the lv one -- the same constraint that forced
    the error amplifier onto a PMOS pair, with the opposite answer. It runs from the
    1.2 V rail so its output needs no level shift.
    Its threshold is a tap off the reference chain rather than a local divider.
    Generating it locally was tried and rejected: a second divider on vref loads it
    and shifted the regulated output from 1.21 V to 0.998 V. Splitting the lower leg
    1 : 0.1 : 0.9 gives both taps from the same 2 uA.
    Current limit senses the pass current 1:1000 through a device sharing the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
    [ldo_capless.sch, ldo_ilim.sch, ldo_pgood.sch, ldo_vref.sch]
2026-08-30 sim: measure the remaining specification lines, and compare against the proposal
    Adds the testbench for the four lines that DC, loop-gain, trim and PVT do not
    cover, and records every proposal line against what the schematic measures.
    Passing, several comfortably: output range, trim monotonicity, line regulation,
    load regulation at 0.39 mV against a 20 mV limit, phase margin over PVT,
    temperature range, and the full control field except one bit.
    Three failures, now measured rather than assumed:
    - dropout 461 mV against a 250 mV limit; the pass array is too small, roughly 9
    ohms where 5 is needed, and the fix is width
    - load-transient droop 513 mV against 120 mV; the crux the proposal nam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
2026-08-30 doc: slot requirements -- pins, power and clocks
    Sets out what the block needs from the harness so pin allocation can be scoped
    without reading the whole document: one dedicated low-resistance pad for vout and
    nothing else sole-use, the shared harness resources including the 1.2 V digital
    rail the block genuinely requires, 7 control and 2 status bits, no clocks, and
    the current budget for sizing the slot power switch.
    Built from the implemented port list rather than the proposal, and flags that the
    muxable Kelvin sense pin the proposal asked for is not in this revision.
2026-08-30 doc: point the integrator at the slot-requirements and comparison sections
2026-08-30 doc: state the assumptions the design rests on
    Adds an Assumptions section covering the process, the slot supply and the harness
    resources, each with what it is based on, so a reviewer can check them against
    the harness instead of finding a mismatch in the schematic.
    Two are marked unconfirmed because they are. The 1.2 V control-bus rail is
    assumed available -- the harness README describes the pallet as getting a 3.3 V
    supply from a pMOS power switch and says nothing about a second rail. And ibias
    is assumed to be 10 uA while the harness nets suggest 250 nA and 1 uA sources;
    the amplifier tail, the preload and the current-limit reference all mirror from
    it, so that is a change of mirror rat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
2026-08-30 design: align the bias to the 1 uA the harness actually provides
    The harness bias nets are ibias1_250n, ibias1u_* and ibias2_1u, so a pallet gets
    1 uA. The block was drawn around 10 uA. Re-ratioed rather than redesigned: Mn1 is
    10x the reference device so the amplifier internal currents are unchanged, and
    the three NMOS mirrors hanging off the reference -- preload, power-good tail and
    current-limit reference -- are 10x in width.
    Regenerating a 10 uA reference node internally, so those three could keep their
    original widths, was tried and rejected on current: that leg draws its 10 uA from
    vin and took quiescent current from 39 to 47 uA against a 30 uA typical. Width is
    nearly free here, supp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
    [ldo_capless.sch, ldo_erramp.sch, ldo_ilim.sch, ldo_pgood.sch]
2026-08-30 design: cascode the current sense so its Vds tracks the pass device
    Without it the sense device drain sits near ground, so it sees Vin while the pass
    device sees Vin-Vout, and that error GROWS as the supply falls because the pass
    device enters triode while the sense device stays saturated. The limiter fired
    before the pass device had run out -- the dropout sweep read 730 mV against the
    460 mV the device actually achieves. A protection circuit that fires early is not
    conservative, it truncates the specified operating range.
    Mcas is gated from vout so the sense drain rides at vout plus a threshold and its
    Vds tracks across the supply range. Trip moves from 62.5 to 59.5 mA, above the
    rated loa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
    [ldo_capless.sch, ldo_ilim.sch]
2026-08-30 design: widen the pass array for dropout, and correct a broken loop testbench
    Pass array 100u x 20 -> x 64. Dropout falls from 460 mV to 149 mV, meeting the
    150 mV typical rather than merely the 250 mV limit. The current-limit sense
    mirrors the array at a fixed width ratio, so Mref is rescaled for the new 1:3200
    ratio and the trip stays near 60 mA.
    More importantly this exposed that the loop testbench had been broken. It
    instantiates cells by hand to break the feedback node, and its port list drifted
    as cells gained ports -- ngspice reported "too few parameters", produced no
    output, and stale result files were read as current. EVERY phase-margin figure
    published between the addition of the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
    [ldo_ilim.sch, ldo_pass.sch]
2026-08-30 ldo: PMOS source-follower gate driver between the amplifier and the pass gate
    The amplifier was driving the ~16 pF pass gate directly, which put that pole low enough to
    dominate the phase margin at every pass-array width. The follower presents 1/gm at that
    node instead of ro, so compensation no longer depends on how wide the pass array is.
    A PMOS follower shifts the gate voltage UP from its input, which is the direction a PMOS
    pass device needs; an NMOS follower shifts it down and cannot turn the device off.
    Benches bind their results to named values so a run that produced nothing cannot read as
    a pass.
    [ldo_erramp.sch]
2026-08-30 ldo: preload sized against the corner sweep; loop now meets 45 deg over PVT
    The second pole at no external load is set by the preload, not by the compensation. With
    1 uA it sat near 6 kHz, close enough to crossover to cost most of the margin. Sweeping the
    preload over all 27 corners gives an interior optimum at 10 uA: worst-case phase margin
    50.2 deg against a 45 deg minimum, with quiescent current 45.6 uA inside the 60 uA maximum.
    The relationship is not monotonic -- 20 uA of preload is worse than 10 uA, because
    crossover then rises into the next pole.
    Two knobs that look like the obvious fixes were swept and both move the wrong way, and the
    doc records them so they are not retried: a larg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
2026-08-30 sim: run the dropout bench with the current limiter off
    Dropout characterises the pass device -- how far the input can fall before the loop loses
    regulation. With the protection active the sweep measures where the limiter fires instead,
    which is a different quantity, and the two loops fighting near the trip point also stops
    the continuation sweep converging. The limiter is measured in its own two benches.
2026-08-30 doc: large-signal response measured, work remaining and open questions
    Three specifications are not met and are now stated with numbers rather than left to be
    found: dropout 573 mV against 250 max, load-step droop 324 mV against 120, and
    load-release overshoot reaching the 3.3 V input rail.
    Droop and overshoot were measured against the design as it stood BEFORE the gate driver
    to establish attribution: 325 mV and the rail, i.e. unchanged. They are set by the 20 pF
    output capacitance, not by the loop -- a 19 mA step held for the microsecond the loop
    needs moves 19 nC, and holding 120 mV across 20 pF requires a 126 ns response.
    Dropout did regress with the gate driver, 149 mV to 573 mV, and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
2026-08-30 ldo: remove the gate driver, cross the PVT sweep with load
    The follower was removed. It appeared to take worst-case phase margin from 25.8 to 50.2
    deg, but that number came from a corner sweep run at NO LOAD ONLY. Crossing load with
    corner puts the same design at 33.4 deg, at ss/-40C/3.6V with 100 uA drawn -- while dropout
    had gone from 149 mV to 573 mV, because a PMOS follower holds its output a threshold above
    its input and that sets a floor on how far the pass gate can be pulled down. It cost a
    specification and bought nothing.
    run_pvt.sh now sweeps load alongside corner, 81 combinations. The load axis is not a
    refinement: judged at no load, more second-stage current looks monotonically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
    [ldo_erramp.sch]
2026-08-30 ldo: sweep resistor corners independently; the resistor corner dominates stability
    Pairing resistor corners with the MOS corner was a convention borrowed from digital
    practice, where best-case sheet means lowest resistance and therefore fastest. It does not
    carry over: rhigh IS the nulling resistor in the compensation, so a best-case sheet moves
    the recovery zero up by a third, which is the worst case for phase margin rather than the
    best. Poly sheet and MOS drive are different process steps and are not correlated.
    Swept independently, 243 combinations, the result is that the MOS corner barely matters --
    the three corners sit within about 2 degrees of each other everywhere -- while the resi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
2026-08-30 doc: record the PDK pin -- both trees, since both are needed
    The PDK is two repositories. ihp-sg13cmos5l is an overlay whose ngspice models are mostly
    symlinks into a sibling ihp-sg13g2 checkout, and cornerMOShv, cornerMOSlv and cornerRES --
    everything that decides phase margin here -- resolve to the second tree. This document
    cited only the first, which governs the MOM capacitor model and nothing else that matters.
    Recorded with content hashes of the model files actually read, because the PDK in the
    simulation container is a flat tree with no git history to check a SHA against.
    Also notes that our pdk-store mirror cannot reproduce these results on its own: it carries
    the same symlinks wit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
2026-08-31 sim: make run.sh reproduce from a clean clone, and netlist all eight cells
    run.sh could not run a single bench. tb_ldo_ac.spice includes
    ldo_cells.spice -- the sub-cell .subckt definitions extracted from the
    TOP-LEVEL netlist, because xschem comments out a cells own .subckt line
    when that cell is the top, so including a standalone cell netlist puts its
    devices at top scope instead of defining a subcircuit. The extraction step
    only ever existed in a private runner, so a clean clone stopped at
    Error: Could not find include file ldo_cells.spice
    Because that happened under set -e on the FIRST bench, the other five never
    ran at all -- their state was simply unknown rather than passing.
    It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
2026-09-01 doc+sim: correct five published numbers, and derive the trip point instead of reading it
    Each of these was a figure that stopped being re-derived when the design moved
    underneath it. All re-measured on the pinned PDK before being changed.
    - Phase margin over PVT: the README published 50.1 deg against a 45 deg minimum,
    i.e. a pass, while implementation.md documented a fail. A fresh 243-combination
    sweep confirms 40.2 deg at ff / worst-case sheet / -40 C / 3.6 V / no load. The
    README now carries that, marked as not met.
    - Loop-stability table: every row was stale, predating the gate-driver removal and
    the stage-2 and preload sizing. Worst case over load moves from 56.6 deg at 30 uA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
2026-09-01 sim: take the PDK location from $PDK_ROOT instead of a fixed path
    Every testbench, corner template, xschemrc and prototype deck hard-coded
    /foss/pdks, so the repository could only be reproduced inside one container
    layout. They now reference $PDK_ROOT, which ngspice expands itself in
    .include and .lib paths; the run scripts default it to /foss/pdks and export
    it. The bare form is required -- ngspice reads ${PDK_ROOT} as a variable
    literally named {PDK_ROOT} and fails.
    Both IHP PDKs have to sit under that one root, which the netlists never
    showed. The models and stdcells come from the ihp-sg13cmos5l overlay, but
    the compiled OSDI models come from the ihp-sg13g2 base, reached through the
    PDK'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
2026-09-01 re-pin to IHP-Open-PDK dev@ab1510c and re-measure every number
    Upstream merged the SG13CMOS-5L overlay into IHP-Open-PDK (PR #1124), so base and
    overlay are one tree under one commit. Two things in that pin move this block.
    The rhigh corner re-alignment (commit 4b7d7422, an ancestor of dev) narrows the
    sheet corners from +/-25 percent to +/-14.7 percent and removes a -0.04 um width
    correction. Worst-case phase margin over 243 corners goes from 40.2 to 45.6
    degrees, with no corner below the 45 degree minimum for the first time. The
    earlier estimate of that fix, made by editing two numbers in a local copy of
    cornerRES.lib, predicted 43.9 and concluded a degree would still be missing; it
    was w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
    [ldo_capless.sch, ldo_erramp.sch, ldo_vref.sch]
2026-09-02 cace: DC regulation characterized, and a published number corrected
    First parameter ported to CACE, which produces the datasheet shape the challenge asked
    every project for: one table per netlist source, the same rows in each, unrunnable rows
    marked Skip rather than dropped. Output voltage, line regulation and load regulation all
    pass, and CACE derives the schematic and symbol SVGs from the xschem files as it goes.
    The .meas definitions are copied from sim/tb_ldo_dc.spice unchanged and the template
    reproduces that bench exactly - vo_lo 1.20896, vo_hi 1.20922, vo_noload 1.20920,
    vo_fullload 1.20894, identical to its own log. That is the whole point: the datasheet
    and the gate cannot report d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
2026-09-02 datasheet: derive every published figure, and fix the three that had drifted
    The challenge asks every project for a summary in CACE's shape: one table per netlist
    source, the same rows in each, rows that cannot run marked Skip rather than dropped.
    tools/datasheet.py emits that from the results sim/run.sh and sim/run_pvt.sh already
    produce. doc/datasheet/ldo_capless_schematic.md is its output.
    CACE itself is not a dependency and the cace/ directory is removed. It cannot consume
    .spice testbenches at all - upstream declares that template branch and leaves the body
    as a TODO - so using it meant carrying a patched fork AND a second copy of every bench
    in its template dialect. Two copies of a be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
    [datasheet.py]
2026-09-02 datasheet: render schematics here too, plus the footer and the corrections e2ab24b missed
    sch2svg.py and its sym_art.json symbol cache move in from private tooling, for the same
    reason the numbers did: a published figure whose generator is private cannot be
    re-derived by the person reading it. The block now ships everything that made its
    datasheet.
    It caught stale figures immediately. The schematics changed in the dev@ab1510c re-pin on
    2026-09-01, but the committed SVGs were last generated on 2026-08-29 - so the published
    drawings showed the pre-re-pin circuit. Three regenerated. The renderer is deterministic;
    that was checked before concluding the drawings were stale rather than the tool u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
    [datasheet.py]
2026-09-02 datasheet: plots, so the loop story is visible and not just tabulated
    Three figures, each carrying something a row cannot. Loop gain and phase at the load where
    the margin is thinnest, so the crossing the number is measured at can be seen. Phase margin
    across the load range, because a no-load sweep does not bound this block - the margin dips
    in the microamp decade and recovers at milliamps, which is why the corner sweep crosses
    load with process instead of stacking them. And all 243 PVT corners as a distribution
    against the 45 degree line, because the worst corner is the only number that matters but a
    reader wants to see how much of the population sits near it.
    Each plot's annotation is der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
2026-09-02 datasheet: draw the load step and the PSRR curve, now that the data exists
    Both of this block's headline failures are shapes, and neither survives a table. "338 mV
    of droop" says nothing about how long the output is out of regulation; "to the 3.3 V rail"
    says nothing about how sharp the release excursion is, or that it is an over-voltage on
    thin-oxide devices rather than a settling wobble. Same for rejection: supply noise does not
    arrive at 1 kHz, and the curve shows where rejection actually collapses.
    tb_ldo_perf.spice measured all of this and wrote no waveform, so the figures could not
    exist. Two wrdata added after the existing .meas statements - relative paths, because the
    runner works i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
    [datasheet.py]
2026-09-02 sim: $PDK may be either variant now, and say why it could not be before
    The CMOS5L migration into IHP-Open-PDK changed something this header asserted. It said
    $PDK must be the sg13g2 base, because before the merge neither directory held all six
    compiled OSDI models - the base had four and the overlay the other two, so whichever one
    $PDK named, something failed to load.
    The overlay now carries all six: two of its own and four symlinked into the base. They
    resolve because base and overlay are siblings in one tree, which is what the merge did and
    what upstream means by "use $PDK to switch between the PDKs". Verified at dev@17dc8dc -
    PDK=ihp-sg13cmos5l runs this suite with no OSDI errors and me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
2026-09-02 doc: the open questions are mostly answered, so stop listing them as open
    All four questions under "need answers before layout" were answered at the 2026-09-01
    review, and two of the three design-judgement questions were overtaken by the re-pin.
    Carrying them as open misrepresents the block to whoever reads it next - including the
    reviewer who answered them.
    They are kept with their answers rather than deleted. What blocked a block, and how it
    resolved, is the part a reader coming to it later actually needs; a deleted question just
    looks like it was never asked.
    The answers: a 1.2 V rail IS distributed, so nothing needs rebuilding in thick-oxide
    devices. Load step and droop are OURS to spe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
2026-09-02 doc: block diagram says the real slot size
    The diagram the README shows carried "Slot budget ~520 × 250 µm". The slot is ≈530 × 310:
    SG13CMOS5L has no thick top metal, so the core was widened for power distribution, and
    implementation.md has used the larger figure since. A current diagram stating the old one
    is simply wrong.
    Fixed at the source - chipalooza/design/dot/ldo_capless.dot - and re-rendered, so exactly
    one line of the SVG moves. doc/proposal.md keeps 520 × 250 deliberately: it is the
    historical record of what was proposed, not a claim about the block today.
2026-09-02 ldo: the load step is ours to specify, so specify it - and the overshoot is a cliff
    The 2026-09-01 review said the load step and its droop are ours to set. That cannot be
    answered by moving a number: it needs data on how the block behaves against step size,
    which one measurement at 1 -> 20 mA does not give. tb_ldo_perf.spice now sweeps five step
    sizes with the same .meas definitions and the same windows as the original.
    step droop overshoot above nominal
    1->2 mA 55.0 64.8
    1->3 mA 90.2 119.7
    1->5 mA 140.5 231.0
    1->7 mA 178.0 2066.2
    1->10 mA 223.5 2077.0
    1->20 mA 338.1 2083.2
    Two results. The block DOES meet b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
    [datasheet.py]
2026-09-16 sim: name the load-release cliff - it is a dI/dt threshold, not a charge one
    The release overshoot was recorded as a cliff between a 5 mA and a 7 mA step, with
    the mechanism unidentified and the working theory that 20 pF of Cout cannot hold the
    charge. Four diagnostic benches, in the order they were needed:
    tb_ldo_overshoot narrows the bracket to 6.0..6.5 mA and shows the amplifier doing
    nothing discontinuous across it - eout moves 78 mV in total from a 3 mA to a 7 mA
    step and its recovery slew is smooth. What does change is WHEN the peak occurs: at
    or below 6 mA it coincides with the end of the load edge, above it the output keeps
    climbing for three microseconds after the edge is over.
    tb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
2026-09-16 sim: prototype a slew boost for eout, and find where the topology stops
    Follows the dI/dt finding: the pull-up has to be large during the release and absent
    from the loop, which a wider XM6 cannot be. XMpb is held off at the operating point
    and turned on by the rising edge of vout itself, through a high-pass onto XMnb biased
    at the ibias node so it sits at the threshold of conduction.
    At the typical corner it does everything asked. The 1 to 20 mA release goes from the
    3.3 V rail to 255 mV of overshoot, quiescent current rises 0.17 uA, PSRR at 1 kHz is
    unchanged to five figures, and the 243-corner phase margin minimum is 46.04 deg
    against the blocks own 45.62 with none below 45 - measured, b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
2026-09-16 doc: the release overshoot is a rate threshold, not a Cout problem
    README and implementation.md both recorded the three unmet specifications as three
    views of one limitation - 20 pF of output capacitance against a 19 mA step. That is
    right for droop and PSRR and wrong for the release overshoot, and the difference
    decides the fix: sizing Cout for droop would leave the over-voltage exactly where it
    is. The measurements are in sim/ and the docs now carry the tables rather than the
    conclusion alone.
    Also corrected: the README described a 4-wire Kelvin output. implementation.md has
    recorded for some time that the sense pin is not in this revision and the block brings
    out a single vout, so the fr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
2026-09-16 sim: error-sensing boost, and the hybrid that came out of it
    Two more topologies after ldo_boost.tpl, and the second one is the first that is off
    at the operating point, blind to the droop recovery AND fast enough to matter.
    ldo_ovboost.tpl senses vfb against a tap on the existing reference divider rather than
    dv/dt at vout. Splitting XR1 into XR1a and XR1b with the same total length leaves vref
    untouched and makes the threshold a resistor ratio that tracks it, which an offset
    built by skewing the input pair would not.
    Two things it taught, both measured. The first version drove the output device straight
    from the comparator and it conducted at the operating point - 393 uA against 35.8, th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
2026-09-16 sim: the hybrids residual four corners are the ibias coupling, not the drive
    Three results, and the first two rule out what it looked like. Weakening the output
    devices fivefold moves those corners by under a millivolt, so the boost is not slamming
    the output down. The same corner run with the vref divider split but no boost at all
    returns 0.4322296 V, bit-identical to the untouched control, so the split is innocent.
    What is left is XCb coupling vout onto nb while nb is biased at the shared ibias node
    through XRb - every large excursion at vout then steals from the 1 uA reference, and
    res_bcs makes XRb smaller and the theft larger at exactly the temperature where the
    amplifier can least affo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
2026-09-16 sim: local threshold reference clears the last four corners
    XRb returned to the shared ibias node, so every large excursion at vout stole from the
    1 uA reference - four of 81 corners drove the output negative during the load step, all
    at 110 C with res_bcs. XMpl/XMrb give nb a local replica of that threshold instead, so
    the injected charge lands on a node nothing else reads.
    Over the same 81 transient corners: none at the rail against 81 of 81 without the
    boost, none negative against four with the shared reference and five with dv/dt alone,
    worst overshoot 573 mV. At the corners that used to fail the droop is now 0.4321 V
    against the controls 0.4322 - the boost no longer perturbs the load s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
2026-09-16 sim: re-run all six published benches against the boost, and attribute what moves
    The boost had been judged on the rows it was aimed at - overshoot, droop, quiescent
    current, PSRR, startup, phase margin. The block publishes more: dropout, trim range and
    monotonicity, current-limit trip, line and load regulation. A fix that cured the
    over-voltage and broke the current limit would be worse than the defect, and nothing run
    so far would have seen it. This runs the six published benches against the boosted
    netlist and emits the datasheet check.
    Result: nothing breaks. Current limit, line regulation, PSRR and trim monotonicity are
    unchanged, and every row still passes its spec bound. Four publish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
2026-09-16 sch: the slew boost is in the schematic, and it reproduces the prototype exactly
    New ldo_boost cell, 17 devices: an over-voltage comparator against a new vref_ov tap
    vetoing a dv/dt path, with both output devices in series from vin to eout so current
    reaches the pass gate only when the output is above its regulation point AND rising
    quickly. Neither conducts at the operating point, so neither adds gm to the loop - the
    property a wider XM6 could not have.
    ldo_vref splits XR1 into XR1a and XR1b to bring out vref_ov, a third tap on the same
    chain. Same argument as vref_pg: a second divider would load the reference, and a tap
    tracks vref because it is a resistor ratio.
    Verified against the net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
    [ldo_boost.sch, ldo_capless.sch, ldo_erramp.sch, ldo_vref.sch]
2026-09-16 doc: republish the figures - the over-voltage is fixed, and what it cost
    The slew boost is in the schematic, so the figures it moves get republished rather than
    left drifting. Twelve rows now pass the drift gate against a fresh run of the suite and
    the 243-corner sweep.
    The headline: load-release overshoot is 235.6 mV at the typical corner and 573 mV at the
    worst of 81 transient corners, against an unboosted design that reached the supply rail at
    81 of 81. What the review asked to have fixed - an over-voltage on thin-oxide devices - is
    gone. The 120 mV target is still missed so the row stays failing, but it is an ordinary
    excursion now rather than a reliability hazard.
    What it cost, publis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
    [datasheet.py]
2026-09-16 doc: vout is not Kelvin sensed - correct the datasheet pin description
    The datasheet pin entry read "Regulated output (Kelvin sensed)". The block brings out a
    single vout and there is no sense pin; the proposal asked for a muxable vout_sense and it
    was never built. The same claim was corrected on the README front page earlier and this
    copy was missed, so a reader hitting the datasheet first would still have found it.
    The replacement says what the pin IS rather than only what it is not, because the
    constraint is the useful part: one dedicated low-resistance pad carrying the full 50 mA,
    where a shared mux path fails because a 1 ohm switch drops 50 mV at that current - more
    than the whole load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
2026-09-16 tools: check the datasheet pin list against the schematic ports
    doc/datasheet/ldo_capless.md is HAND-WRITTEN - datasheet.py only ever generates
    <name>_<source>.md - so its Pins block was a second copy of the port list that nothing
    compared against anything. Exactly the shape of thing this file exists to catch for
    figures: a human-maintained fact that goes stale silently.
    It had already gone stale, describing vout as Kelvin sensed when no sense pin was ever
    built, and it survived a correction to the same claim on the README front page because
    nothing linked the two. ldo_vref gaining a port in a single afternoon is how a set of
    fifteen names desynchronises without anyone noticing.
    The check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
    [datasheet.py]
2026-09-16 tools: check the hand-wired benches against the real port order
    tb_ldo_ac and tb_ldo_pvt instantiate the sub-cells by hand, because breaking the feedback
    loop needs a node ldo_capless.sch does not have. So a port added to a cell does not reach
    them and the order in those lines is maintained by a person.
    ngspice catches the easy half loudly - too few parameters. It cannot catch the dangerous
    half. When ldo_vref gained vref_ov the bench line was written in the order of the cell
    specs ports list rather than the order xschem emits: the right NUMBER of nets in the wrong
    sequence. vref_ov was tied to vss, the block stopped regulating at 0.97 mV, and the
    243-corner sweep reported 61 degrees of pha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
    [datasheet.py]
2026-09-16 layout: area budget from generated geometry, and Cout does not fix the droop
    First real layout step: instead of estimating, instantiate every device in the netlist
    with the PDKs own KLayout PyCell and measure its bounding box. All 70 generate, none fail.
    Cm 37346 um2 (22.7%), Cout 15688 (9.5%), pass device 15680 (9.5%), boost ~6000 (3.6%)
    70 devices total 80085 um2 = 48.7% of the 530 x 310 slot
    The pass device had never been quantified and is as large as Cout. Three objects are 41.7%
    of the slot between them, so they decide the floorplan. tools/area_budget.py reproduces it
    and states plainly that it sums device bounding boxes - no routing, guard rings, taps or
    dead space - so the total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
    [area_budget.py]
2026-09-16 layout: first-cut floorplan, as checked data rather than a drawing
    Placement declared as coordinates with the checks that matter - every block inside the
    530 x 310 slot, none overlapping - so a floorplan cannot claim to fit when it does not.
    It caught two errors in my own first attempt: Cm running 95 um off the top edge, and the
    pass array overlapping the enable block. A diagram would have shown both as neat rectangles.
    Three measured facts decide the shape, and none of them were guessable:
    Cm is 193.0 x 193.5 um in a 310 um slot - 62 percent of the height. With Cout at 125.5,
    193.5 + 125.5 = 319 and they cannot share a column. That single fact fixes 318 um of the
    530 um width and everythi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
    [area_budget.py, floorplan.py]
2026-09-16 layout: fold pitch confirmed against the DRC deck - 1.18 um, not the 2.5 assumed
    The floorplan carried one assumed number and flagged it as the one thing not measured. It
    was wrong by more than a factor of two.
    Four rhigh PyCells were placed side by side at descending pitches and the full FEOL deck
    run on each:
    GatPoly gap 0.05 0.10 0.15 0.18 0.20 um
    violations 6 6 6 0 0
    The threshold sits exactly on Gat_b = 0.18 um, the minimum GatPoly space, so the floor is
    1.0 um of resistor body plus 0.18. The test resistors carried their end contacts, so those
    are included. Adopted 1.2 um, a hair above the floor and on grid.
    ⛔ The check was falsified befor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
    [floorplan.py]
2026-09-16 sim: droop responds to the amplifier tail current, not to Cout - and not to eout slew either
    A lever nobody had: droop falls with the error amplifiers tail current. 338, 265, 226,
    184 mV for tails of 10, 15, 20, 30 uA, against Iq of 41.5, 46.4, 51.2, 60.8. The 60 uA
    budget caps the tail near 8u, which buys 226 mV, and the curve is flattening - so 120 mV
    is not reachable this way. Quantified and not sufficient, which is still far better than
    the account the documents carried until this morning, which was add more Cout.
    ⛔ The mechanism I proposed is wrong and the bench says so. Droop is eout slewing into Cm
    at I_tail over Cm closed almost perfectly on the arithmetic: 0.2525 V/us times 47.9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
2026-09-16 sim: droop mechanism found - a ramp-tracking error set by loop transconductance
    Found by measuring the pass current instead of the gate that controls it. At the end of
    the load edge the pass device delivers 20.0063 mA against a 20.000 mA load - it tracks a
    19 mA ramp to within 6.3 uA. The 338.2 mV droop is 6.76 pC across 20 pF, an average deficit
    of 6.76 uA. The loop tracks to three parts in ten thousand and that residue is the entire
    droop.
    Every previously puzzling observation follows. Cout does nothing because a steady tracking
    error during a ramp is not an integration. eouts trajectory does not change with tail
    current because eout must arrive at the same place either way - the pass dev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
    [floorplan.py]
2026-09-16 doc: droop is specified as a load SLEW RATE, and the block passes it
    The 120 mV droop target came from our own proposal and the 2026-09-01 review confirmed the
    load step and its droop are ours to specify. Now that the mechanism is known, the right
    thing to specify is not a smaller number against the same condition - it is a different
    condition.
    Droop is a ramp-tracking error, so it is a function of dI/dt and not of step size. A limit
    written as 120 mV at a 20 mA step names no condition the block can be held to. Measured on
    the same 1 to 20 mA step with only the edge changing: 338.2 mV at 19 mA/us, 242.9 at 9.5,
    167.1 at 4.75, 127.6 at 2.92, 99.4 at 1.90, 64.8 at 0.95. The block holds 120 mV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
    [datasheet.py]
2026-09-16 sim: PSRR is a loop-gain problem, and it is the same trade as droop and phase margin
    PSRR(f) = 47 dB minus loop gain(f), exact over four decades - 48.23, 47.46, 47.40, 45.86
    at 10 Hz, 100 Hz, 1 kHz and 10 kHz. The open-loop supply coupling is a constant 47 dB, the
    pass devices gm times its output impedance, and everything the block achieves is the loop
    dividing it down.
    None of the suspected causes survived. Not Cout, which implementation.md has now blamed for
    the release overshoot, the droop and the high-frequency PSRR and been cleared of all three
    by measurement. Not the compensation tying the pass gate to ground, which was this benchs
    own opening hypothesis - eout tracks vin to within 0.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
2026-09-17 sim: cascoding the first stage will not fix PSRR - measured before building it
    The obvious next move after finding PSRR is a loop-gain problem was gain without
    bandwidth: cascode the first stage so ro rises while gm, and therefore UGF and phase
    margin, stay put. Tested in its cheapest form first - scale W and L of the input pair and
    the mirror together, which raises ro with L while gm follows W over L and stays constant.
    A cascode raises the same quantity by the same mechanism, so if ro is the lever this had
    to show it.
    It is not. Four times the device size buys 0.7 dB of loop gain at 1 kHz - 82.47 to 83.16 -
    and makes PSRR, droop and phase margin all slightly worse. Output resistance is no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
2026-09-17 sim: the cascode negative result now has its mechanism measured, and a correction
    The previous commit recorded that cascoding the first stage will not fix PSRR, but left the
    reason unexplained and flagged an 8.7 dB gap between a single-pole prediction and the
    measurement. sim/rocheck.sh closes both.
    ⛔ The gap was my error, not the circuits. The unity-gain frequency had been read from the
    NO-LOAD loop file and applied to the 1 mA loops gain - same quantity, different operating
    point. Read from one file the arithmetic closes to 0.01 dB.
    ✅ And the mechanism is now measured rather than guessed: ro genuinely rises. 4x L lifts the
    DC loop gain 11.12 dB against the 12.0 dB predicted, and move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
2026-09-17 ldo: PSRR is a slope, so specify it as one - mask replaces the single 1 kHz number
    The 40 dB at 1 kHz limit was missed by 4.9 dB typical and 6.3 dB at the worst corner, and
    nothing reaches it: 30 uA of tail buys 40 dB and costs 20.4 degrees of worst-corner phase
    margin, and cascoding was measured not to help at all because output resistance stops
    mattering above 100 Hz. What was left was the specification, and the 2026-09-01 review
    confirmed that is ours to set.
    ⛔ The old limit was not merely unmet, it was the wrong SHAPE. Open-loop supply coupling is a
    constant 47.4 dB, flat to 1.5 dB from 10 Hz to 10 kHz, and the loop is an integrator through
    that whole band, so rejection falls 20 dB pe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
    [datasheet.py]
2026-09-17 layout: the pass array abuts legally - DRC-verified, and the pitch is a cliff not a spacing
    First real layout step. tools/layout_pass.py generates the pass-device array as GDS from the
    PDK PyCell and tools/passdrc.sh runs the IHP DRC deck across a pitch sweep, so the floorplan
    assumption that 64 devices lay side by side is now measured instead of assumed. It holds:
    abutted at 2.42 um they are clean. Floorplan corrected 153.6 -> 154.9 um.
    🔑 The pitch is a CLIFF. gap 0 is clean because adjacent nwells MERGE; 0.02, 0.1, 0.3 and
    0.5 um all report NW.b, nwell minimum space 0.62 um; 0.62 is clean again. There is no legal
    pitch between touching and 0.62 um apart, which across 64 devices is 40 u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
    [floorplan.py, layout_pass.py, passprobe.py]
2026-09-17 doc: bring the prose up to what was measured - three attributions were still wrong
    The drift gate compares README FIGURES to the simulations behind them, and passed throughout.
    It does not read prose, and the prose had drifted badly.
    ⛔ implementation.md still said droop is set by Cout, under a heading that said so and a
    paragraph that ended Cout is the variable - while the body in between already explained why
    that was wrong for the release overshoot. Sweeping Cout from 20 to 56 pF moves the droop
    0.3 mV in the WRONG direction. Corrected to what tb_ldo_droop.spice established: a
    ramp-tracking error set by the loop transconductance, tracking a 19 mA ramp to three parts in
    ten thousand. ⟹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
2026-09-17 doc: add a Current status section to the README
    There was a one-line status blockquote saying schematic and nothing else. A reader landing
    on the repo could not tell what was met, what was not, or how far the physical design had
    got without reading implementation.md end to end.
    Six bullets, generic, with the numbers left to the linked docs: what is captured and
    reproducible, that one specification is still missed and which, that two were restated to the
    quantity the physics governs and then passed, that verification is across corners rather than
    at one operating point, and that physical design is early.
    ⛔ The last bullet is the one that earns its place - the two limits an integrator has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
2026-09-17 doc: the rendered SVGs had drifted - regenerate them, and the block diagram was the worst of it
    Asked whether the SVGs were current. The generated DATASHEET figures were - regenerating
    produces byte-identical files. The rendered SCHEMATICS were not.
    ⛔ doc/schematics/ held eight SVGs for nine cells: ldo_boost.svg did not exist at all, and
    ldo_vref.svg and ldo_capless.svg predated the boost work, so neither showed the vref_ov tap
    nor the x_boost instance. The README describes that directory as rendered SVGs of every cell,
    which was simply false. Regenerated from the .sch files with tools/sch2svg.py; exactly those
    three changed and the other six came back byte-identical, which is the rendere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
2026-09-17 sim: default PDK to ihp-sg13cmos5l, the process this IP is named for - and correct why the benches failed
    ⛔ I BLAMED THE WRONG THING. When every bench died on cap_cmomf_mod after netlisting had
    already succeeded, I attributed it to the PDK variant and wrote that into rocheck.sh, into
    the commit that added it, and into my notes: that cap_cmomf resolves only under
    ihp-sg13cmos5l. Tested properly, that is false - with SPICE_USERINIT_DIR set to match
    PDK_ROOT, EITHER variant runs this suite clean.
    ✅ The real cause is the one run.sh now warns about: IIC-OSIC-TOOLS already exports
    SPICE_USERINIT_DIR pointing at its own bundled /foss/pdks, so the only-if-unset guard leaves
    it alone even when t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
2026-09-17 doc: connectivity is checked per cell, and a PDK gap can empty the netlist
    All eight cells pass a connectivity pass over their own netlists - no shorted
    device terminals, no unterminated nets, no auto-generated names surviving - with
    every capacitor present.
    Also records the trap that made the first reading meaningless: xschem writes an
    unresolvable symbol as a comment and carries on, so a netlist built against a PDK
    without cap_cmomf is syntactically valid, simulates, and is missing parts.
    ldo_capless loses five capacitors that way against the IIC-OSIC-TOOLS bundled
    PDK, which still ships the pre-rename cap_mfringe. Grep a fresh netlist for
    IS MISSING before trusting anything derived from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
2026-09-19 Add a wired rendering of ldo_boost, and the before/after it was judged on
    The generated schematic connects nothing. Seventeen devices carry sixty-two
    label-pins and sixty-two stub wires that run from a terminal to a name and stop,
    so every node is a text match rather than a drawn connection. It netlists
    correctly and reads as a parts table, which is the wrong artifact to hand a
    human for review.
    ldo_boost_wired.sch is the same seventeen devices in the same positions with
    local nets drawn as wires: sixty-four segments, label-pins down from sixty-two
    to twenty-nine, and vss now an actual bottom rail with junction dots. Nothing
    moved, so the two files isolate the effect of wiring from the effe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
    [ldo_boost_wired.sch]
2026-09-19 Render the ldo_boost before/after with the block's own sch2svg, not a one-off
    The previous commit shipped images from a renderer written for the occasion,
    which was wasted work: tools/sch2svg.py and its cached sym_art.json have been in
    this tree since September 2 and do the job better. They carry the title and the
    design commentary from the schematic, annotate each device with W and L, and
    draw the PDK's own symbol artwork, none of which the one-off did.
    Replaces before/after.{svg,png} with ldo_boost.{svg,png} and
    ldo_boost_wired.{svg,png}, named for the schematics they render so the pairing
    is obvious and a third schematic does not need a third adjective.
    One gap this exposes rather than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
2026-09-19 Give sym_art.json a generator, and add the four symbols it was missing
    Cb rendered as a labelled box while every transistor rendered as a transistor.
    The cause was not a missing symbol but a stale cache: the PDK renamed
    cap_mfringe to cap_cmomf and its pins c1/c2 to c0/c1, sym_art.json kept only the
    old name, and the renderer silently fell back to a box. The capacitor is the one
    device in this cell whose value carries the compensation argument, so it is the
    worst one to draw as a rectangle.
    The real defect is that a cache had no generator. tools/sym_extract.py is that
    generator: it reads the PDK .sym files and rebuilds the cache, with --check
    reporting drift and writing nothing, which is th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
2026-10-04 floorplan: refit to the real 537.15 x 273 um slot, without changing a device
    The slot was carried as 530 x 310 um, a verbal figure the drawn harness wrapper
    never had. Against the real outline, Cm, Cc and the enable+Rls region sat up to
    32.5 um above the top edge while this script reported that everything fit.
    Every move is a region reshaped or a block relocated; no W, L, value or finger
    count changes, so no simulated figure moves and datasheet --check still passes:
    - Cm drops to y 67. The band under it shrinks to 55 um, which the error amp
    (259 um2 of devices) and the vref divider (424 um of rhigh, a 10 um Cf) never
    needed more than.
    - XRls folds 90 um tall instead of 120.
    - Cc, the Mi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
    [datasheet.py, floorplan.py]
2026-10-04 floorplan: three regions corrected by placing the real devices, and a placement map
    Placing every PyCell at its netlist size (chipalooza tools/slot_gds.py) found three
    places where this floorplan was wrong, all by under a few microns but all real:
    - ilim and pgood were 42 um tall; each holds a single-finger device standing on end
    (ilim Mref, w 50 um, is 51.0 um tall). They were sized by area, never by their
    tallest device. Now 60 um, which the space above them always allowed.
    - The pass array is 101.24 um tall in a 101.2 um region; now 101.3.
    - snake() reserved cols x pitch, but the PDK serpentine is (cols-1) x 1.18 plus one
    1.40 um contacted segment, so XRnx was 0.08 um short. Formula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
    [floorplan.py]
2026-10-04 floorplan: room for what routing adds -- cap terminal stubs, one shared pass-array well tap
    Routing the slot needs three things the PDK cells lack, and two of them take room:
    - each MOM cap gets 1 um Metal4 terminal stubs out of its left and top edges (the
    PDK pins are 0.2 um, below minimum width), so each cap region grows 1 um each way;
    Cc and Cout move so Cout stays 1 um clear of Cc plates;
    - the pass array is one shared N-well with ONE well tap at its left end (a tap per
    finger made it 293 um wide) plus a gate contact per finger: 157.5 x 101.5.
    ilim grows 2 um for the wider pMOS. With these, all 137 devices place and the
    routed slot is DRC-clean. No device changes; datasheet --check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
2026-10-04 README: placed, routed and checked -- and why the layout is not committed yet
    The status said full layout, routing and LVS had not started. They have: every
    device is placed, the block is routed to the slot outline on the harness pins,
    DRC is clean on the PDK KLayout deck, antenna is clean, and LVS matches except the
    11 folded resistors (which match when given their drawn serpentine parameters).
    The README now says so, and lists what holds the layout back from gds/: the
    minimum-width 50 mA path, the folded-resistor schematic change and re-simulation,
    MOM capacitor extraction at about twice the model, and the harness bit and ground
    decisions. It also records what routing needed that the PDK c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
2026-10-08 floorplan: vin/vout straps for the 50 mA path, sized and checked against the process spec
    Metal2 over every pass finger source and drain (Via1 every 1 um), a Metal3+Metal4
    vout band at the pin height, two Metal3+Metal4+TopMetal1 vin bands, and a 28 um
    TopMetal1 feed from vdd_3v3. strap_check() prints current per segment and IR drop:
    26 mV vin, 8 mV vout at 50 mA, max sheet R. The harness vout pin (Metal3, 24.77 um)
    is 49.5 mA at JMAXM3 and is reported apart as a harness limit. Routed DRC 0; LVS as
    before (folded rhigh params only), as-folded LVS match.
2026-10-08 README: 50 mA path strapped and checked (26/8 mV IR at 50 mA), harness pin 49.5 mA limit, extracted coupling, MOM extraction now at model; MOM pin note corrected
2026-10-18 doc/figures: presentation circuit figures (cirfig_gen), checked net by net against the xschem schematics
    One SVG per circuit, drawn with cirfig_gen. Each figure is a description of the
    schematic, not a source of truth: README.md carries the per-pin check table
    against the xschem netlist and lists every simplification.
2026-10-18 gds: slot_11.gds and the standalone block cell sg13cmos5l_vyges_ip__ldo_capless
    Control pins routed (en, ilim_en, vtrim0-4 on dig_in 8-20 even, pgood/oc on
    dig_out 0/2). Both files: DRC 0, antenna 0, keepouts clear. Folded rhigh drawn
    value-exact (PDK R of the folded device = straight schematic R within
    0.007 %), checked against LVS; as-folded LVS matches.
2026-10-18 gds: subcells renamed with a block-unique prefix
    The harness reads every project GDS into one magic session before placing
    any; same-named subcells (PyCell variants such as rhigh$6, nmos$7, via_stack)
    collided at read time in the 2026-10-18 test build. Only the block cell and
    slot_N keep their names. Re-checked on these files: DRC 0, antenna 0,
    keepouts clear, LVS as before.
2026-10-18 gds: written without the $$$CONTEXT_INFO$$$ cell (the last read-time cell collision in the harness)
    Re-checked on these files: DRC 0, antenna 0, keepouts clear, LVS as before.
2026-10-18 README: layout handed off (block cell + slot_11 in gds/), folded rhigh by value, control pins, circuit figures
    The top-level figure replaces the block diagram; sub-block figures added.
    Post-layout simulation is still open and says so. Datasheet regenerated:
    unchanged; --check passes.
2026-10-18 README: post-layout gate result: phase margin 39.4 deg worst vs 45 (schematic 45.1); all other rows hold; attribution of the 5.7 deg
2026-10-19 compensation retune for the post-layout phase margin: pair 2.5u, Rz 40.48u, Cc 3.56 pF
    Post-layout the loop had 39.4 deg against a 45 deg floor (schematic 45.1).
    Priced on the extracted netlist over all 243 corners: input pair 5 -> 2.5 um,
    Rz 35.2 -> 40.48 um, Cc 40x40 -> w 69.15 x l 40 um (2.06 -> 3.56 pF by the
    PDK model). Cc grows up its floorplan column. Datasheet, layout and README
    follow once the post-layout gate has run on the re-routed block.
2026-10-19 post-layout gate passes after the compensation retune: 48.4 deg worst (sch 49.4), 0 of 243 below 45
    Re-laid out with the retuned compensation (pair 2.5u, Rz 40.48u, Cc 3.56 pF)
    and re-checked: DRC 0, antenna 0, LVS as before (folded resistors by value),
    keepouts 0. Re-extracted, every datasheet row passes post-layout except the
    load-release overshoot, which already fails on the schematic.
    Cost: PSRR about 2.6 dB lower (worst corner about 1 dB over the mask), droop
    slew rate 2.65 -> 1.77 mA/us (limit 1). Release overshoot worst of 81 corners
    573 -> 422 mV, none at the rail. Datasheet regenerated from the gate run.
2026-10-26 Supply grid, digital row, wide vdd_1v2 and guard rings (layout review items 1, 2, 5, 11, 12)
    - vss/vin grid over the small cells: vss bar from its pin across Cm to a
    spine, vin spine from the top run, interleaved Metal4 + TopMetal1 fingers;
    no Metal4 over a MOM cap or the vref divider
    - the four standard cells in one p+-ringed row by the digital pins, under Cm
    (Cm up 5.5 um): pgood/oc/en wires ~430 -> ~20 um
    - vdd_1v2 routed 1 um wide (non-default rule): series R ~374 -> ~45 ohm
    - p+ ring around every small-device region; fbtrim region 192 -> 70 um tall
    Slot 11: DRC 0, antenna 0, keepouts 0, as-folded LVS match, fold check 0.
2026-10-26 Metal4 grid fingers 1.64 um under the 4 um TopMetal1 bands: full-width Metal4 over the analog routing put 37 fF on vfb and cost 3-5 deg of phase margin at the high-UGF corners
2026-10-26 sch2svg: draw group frames and their titles (same renderer as the PLL)
2026-10-26 Schematics in titled groups (Ridha pattern): top level as one regulation loop (reference, amp, pass, output, Cc above, trim divider below with the vfb return drawn), supervisory row; pgood, boost, il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
2026-10-26 Grid: the two lowest vss rows stop at the spine, clear of vfb Metal3 along the bottom of the amp band (vfb-vss coupling worth 2.0 deg at the worst corner)
2026-10-26 Revert "Grid: the two lowest vss rows stop at the spine, clear of vfb Metal3 along the bottom of the amp band (vfb-vss coupling worth 2.0 deg at the worst corner)"
    This reverts commit 0e6fae4165eac8cba3951a3e48297aba24b91d76.
2026-10-26 Reapply "Grid: the two lowest vss rows stop at the spine, clear of vfb Metal3 along the bottom of the amp band (vfb-vss coupling worth 2.0 deg at the worst corner)"
    This reverts commit 1a545aca4a1756d4fb440a036a574a778c912712.
2026-10-26 gds: the layout-refine layout (grid, guard rings, digital row, vfb spacing, pgood above the ladder; built from 1b7f61f). DRC 0, antenna 0, keepouts 0, as-folded LVS match. main keeps the taped-out GDS
2026-11-09 gds: pass the full IHP KLayout rule set (main + maximal deck)
    The maximal deck found 141 errors the main tables do not check: LU.a 58 (pass array had one
    corner n-tie), NW.e1 9 (HV tap enclosure 0.24 instead of 0.62), M2.d 73 + M3.d 1 (drop islands).
    Pass array: six full-height n-ties tied to vin in Metal1 (taps_at), region x 361, 166.5 wide;
    vin bands merge with the vin spine. Rebuilt with chipalooza slot_route_run.sh 11.
    Full rule set 0 (block and slot), antenna 0, keepouts 0, as-folded LVS match, fold check 0.
    Short PM check: worst 47.76 deg (was 47.20, floor 45).
